rocketman123456/eyou_motor/doc/关节模组样册新20250213.pdf

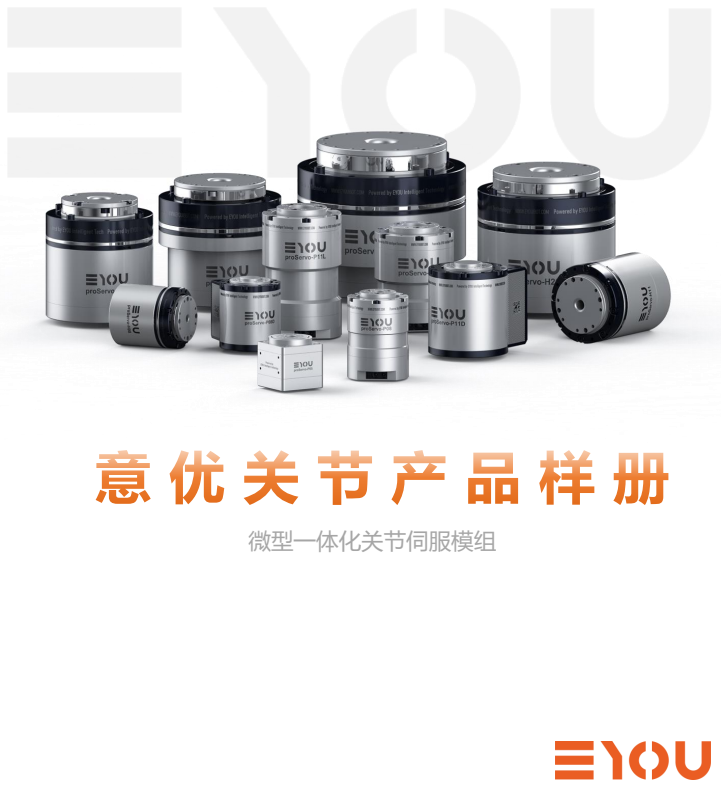
[picture p1: page 1]
意优关节产品样册; 微型一体化关节伺服模组

# 关于意优

### ABOUT EYOU

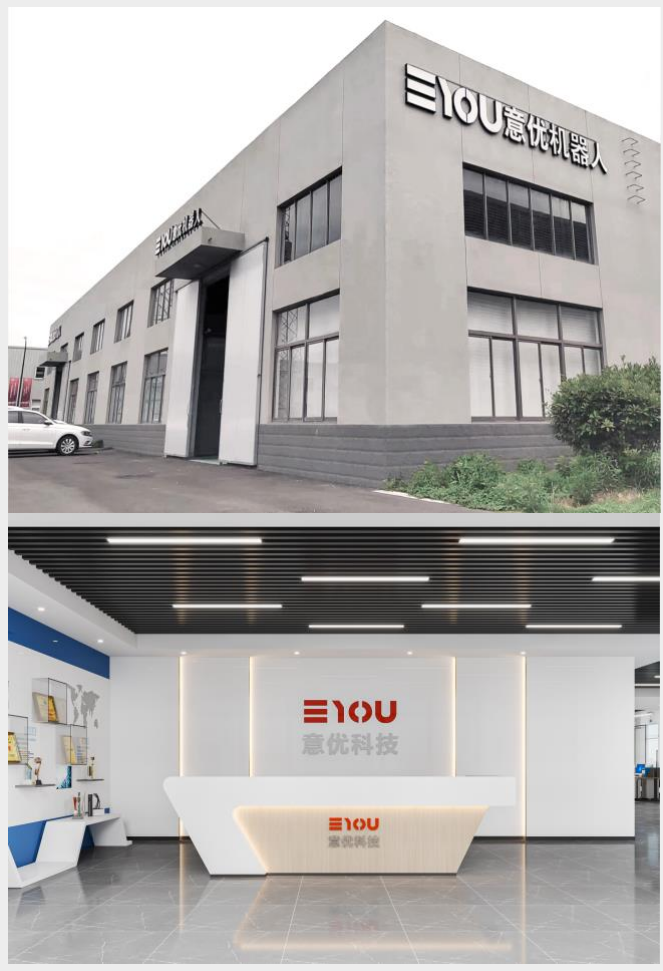
[picture p2: figure]

江苏意优机器人科技有限公司致力于人形机
器人驱动系统的研发、生产和销售，核心团队基
于20多年的机器人研发经验，突破了关节驱控的
高精度控制算法，推出的行星、谐波及推杆关节
模组，涵盖了人形机器人上肢、腰部、下肢能用
到的全身关节，是国内人形机器人核心零部件的
头部供应商。

意优伺服关节模组性能稳定，成本低，已实
现规模量产，产品不仅广泛应用于协作机械臂、
医疗器械、工业模组、智能制造等各种工业机器
人领域，在服务、教育、娱乐等各种人形机器人
应用场景也有着不可取代的地位。

公司研发和运营中心位于江苏无锡中电数字
芯谷，从事人研发人员30余人，生产场地3500平，
依托人形机器人创新链和产业链的有效赋能，意
优机器人多次签约重点重大项目，加入产业集群，
为未来产业发展注入新动力。

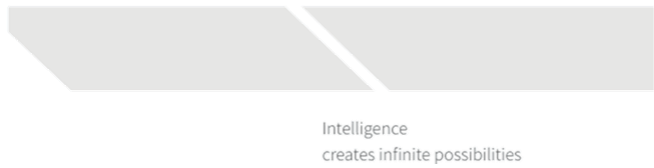
[picture p3: figure]

# 微型一体化伺服模组

### INTEGRATED SERVO MODULE

CHARACTERISTIC

### 技术特点

创新的产品设计

PROSERVO系列伺服，将减速器、电机、驱动三大部件高度集成，形成超小型一体化的伺服模组，

关节采用总线设计，中空走线，大大简化系统结构。 采用高精度双磁编设计，可选抱闸，满足

各种苛刻工况要求。

标准化生产工厂和检测设备

全硬件FPGA驱动设计，速度环、位置环、力矩环闭环速度均达到20KHZ，提供快速动态响应，

同时满足协作机械臂柔性和精度要求。 伺服算法采用ADRC技术，运行更加平稳。

全面的配套软件服务和技术支持

上位机支持LINUX、WINDOWS、树莓派；SDK支持C++\PYTHON\MATLAB\ROS;接口支持USBCAN，

提供CANOPEN主站；为客户多元需求提供专业的解决方案。

高标准配件

高精度21BIT磁环编码器、高能量密度电机、高精度减速器、磁环抱闸，均采用一线品牌合作，

并配置专门的生产厂线，从而确保产能和质量。

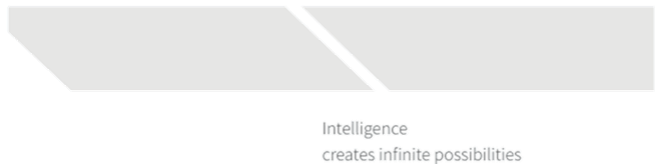
[picture p4: figure]

# 行星一体化伺服关节模组

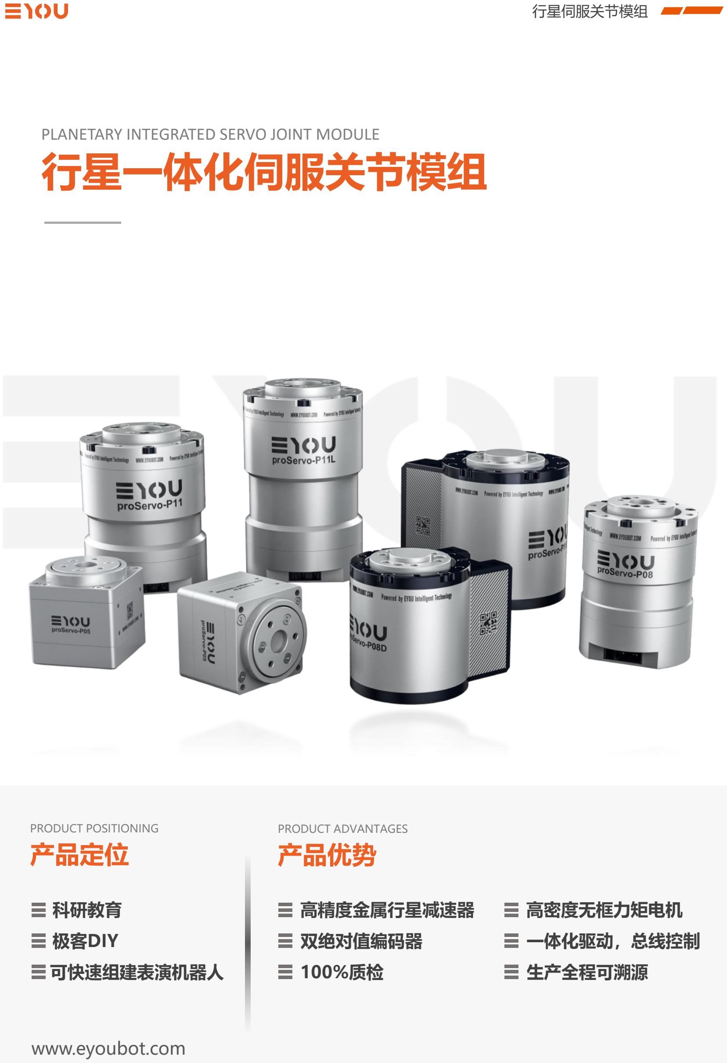
[picture p5: page 4]

PRODUCT POSITIONING

## 产品定位

科研教育
极客DIY

高精度金属行星减速器
双绝对值编码器

PRODUCT ADVANTAGES

## 产品优势

高密度无框力矩电机
一体化驱动，总线控制
可快速组建表演机器人 | 100%质检 | 生产全程可溯源

PLANETARY INTEGRATED SERVO JOINT MODULE

www.eyoubot.com

行星伺服关节模组

PRODUCT ADVANTAGES

# 产品优势

CAN2.0总线
接口频率1MHz

机械式双编码器
精度18bit*2

4点接触轴承，承
受 轴向径向负荷

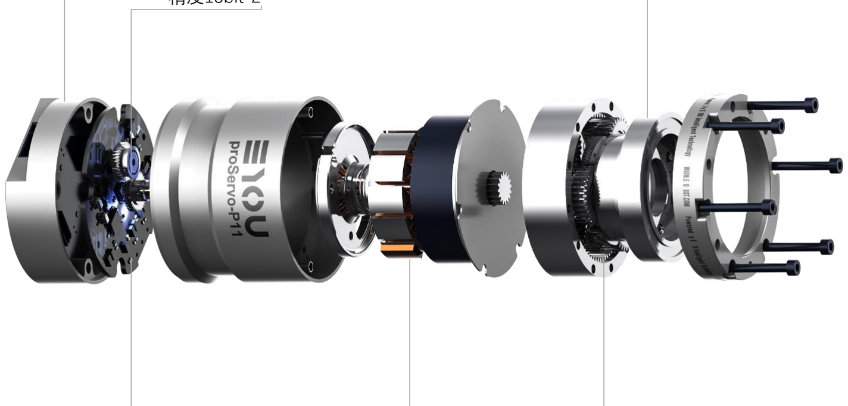
[picture p6: figure]

全硬件FOC驱动
20KHz闭环 周期

高密度无框
力矩电机

精密行星减速器，
高强度低噪音

行星伺服关节模组

www.eyoubot.com

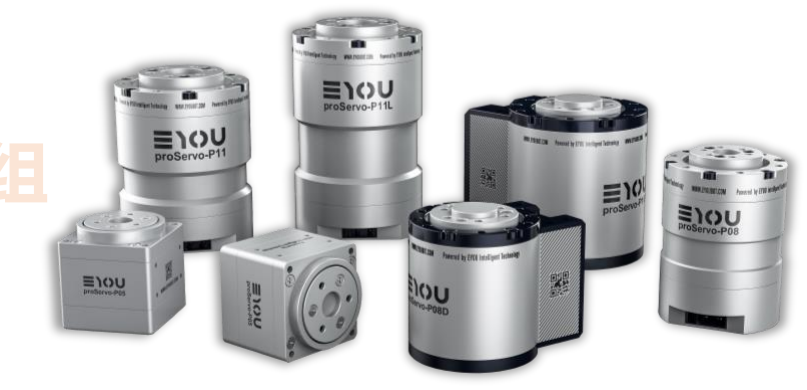
[picture p7: figure]

型号 | PP05 | PP08/PP08D | PP11/PP11D | PP11L-36
电机类型 | 无刷力矩电机
减速器类型 | 行星减速器
直径（mm） | 32 | 40 | 52 | 52
长度（mm） | 33.4 | 52/48 | 64/61 | 83
重量（g） | 82 | 190/199 | 391/436 | 517
减速比 | 6:1 | 36:1
反向背隙 （arcmin） | 12arcmin
噪音（db） | <70db
温度范围（℃） | -20~80℃
工作电压(V) | 24V
最大功率（W） | 36W
额定转速（rpm） | 50rpm
空载转速（rpm） | 200rpm | 80rpm | 80rpm | 50rpm
额定扭矩（nm） | 0.2nm | 1.0nm | 6.6nm | 12nm
峰值扭矩（nm） | 0.48nm | 2.2nm | 14nm | 16nm
转矩系数 （nm/a） | 0.2nm/a | 1.1nm/a | 2.2nm/a | 6nm
轴向承受力（N） | - | 1284 | 1605 | 1605
径向承受力（N） | - | 2520 | 3150 | 3150

# 产品参数

# 行星一体化关节模组

行星伺服关节模组

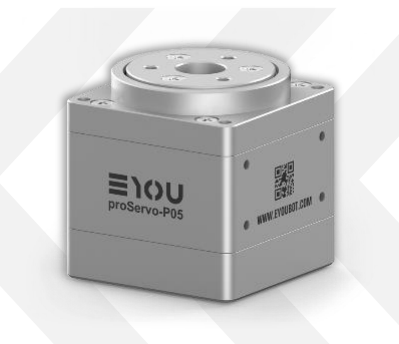
[picture p8: figure]

型号 | 速比 | 无抱闸
PP05-6 | 6 | N

无刷力矩电机

产品名称 Item Name | PP05
直径 | 32mm | 额定转速 | 50rpm
长度 | 33.4mm | 空载转速 | 200rpm
重量 | 82g | 额定扭矩 | 0.2nm
反向背隙 | 12arcmin | 峰值扭矩 | 0.48nm
噪音 | <70db | 扭矩系数 | 0.2nm/a
温度范围 | -20~80℃ | 轴向承受力 | -
工作电压 | 24V | 径向承受力 | -
额定功率 | 35w

行星伺服关节模组

### 系列名 Series Name

## proServo-planet

### 电机型号 Motor model

PP05-6

尺寸安装图 Installation Drawing

产品参数 product parameters

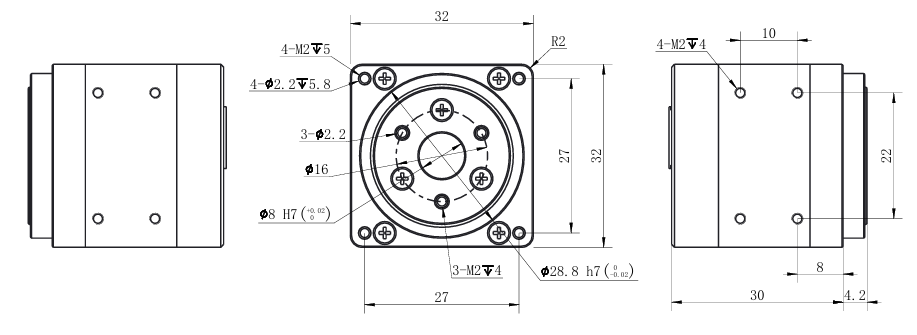
[picture p9: figure]

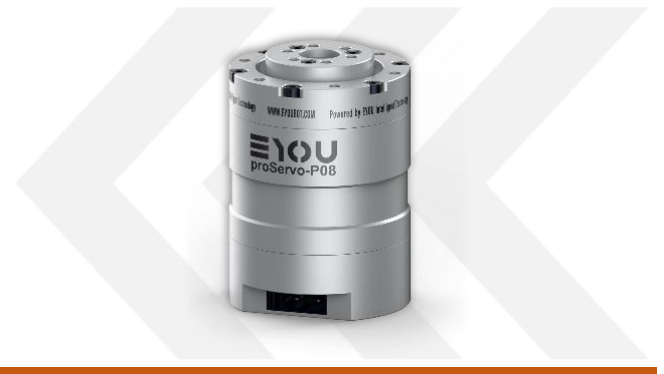
[picture p10: figure]

型号 | 速比 | 无抱闸
PP08-36 | 36 | N

无刷力矩电机

产品名称 Item Name | PP08
直径 | 40mm | 额定转速 | 50rpm
长度 | 52mm | 空载转速 | 80rpm
重量 | 190g | 额定扭矩 | 1.0nm
反向背隙 | 12arcmin | 峰值扭矩 | 2.2nm
噪音 | <70db | 扭矩系数 | 1.1nm/a
温度范围 | -20~80℃ | 轴向承受力 | 1284N
工作电压 | 24V | 径向承受力 | 2520N
额定功率 | 36w

行星伺服关节模组

### 系列名 Series Name

## proServo-planet

### 电机型号 Motor model

# PP08-36_V3

尺寸安装图 Installation Drawing

产品参数 product parameters

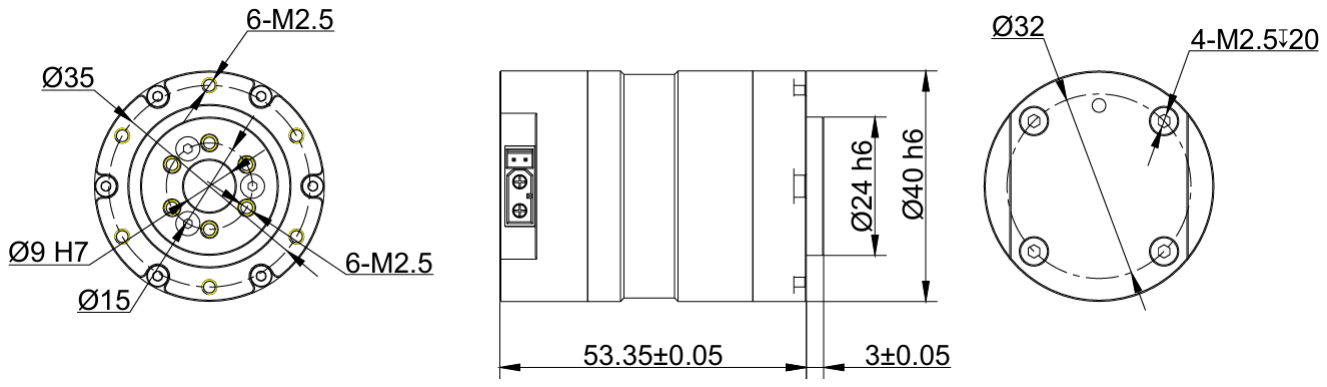
[picture p11: figure]

### 系列名 Series Name

## proServo-planet

### 电机型号 Motor model

# PP08D-36_V3

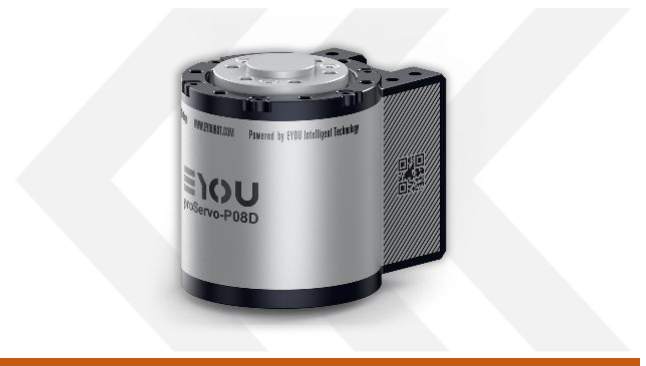
[picture p12: figure]

型号 | 速比 | 无抱闸
PP08D-36 | 36 | N

无刷力矩电机

产品名称 Item Name | PP08D
直径 | 40mm | 额定转速 | 50rpm
长度 | 48mm | 空载转速 | 80rpm
重量 | 199g | 额定扭矩 | 1.0nm
反向背隙 | 12arcmin | 峰值扭矩 | 2.2nm
噪音 | <70db | 扭矩系数 | 1.1nm/a
温度范围 | -20~80℃ | 轴向承受力 | 1284N
工作电压 | 24V | 径向承受力 | 2520N
额定功率 | 36w

行星伺服关节模组

尺寸安装图 Installation Drawing

产品参数 product parameters

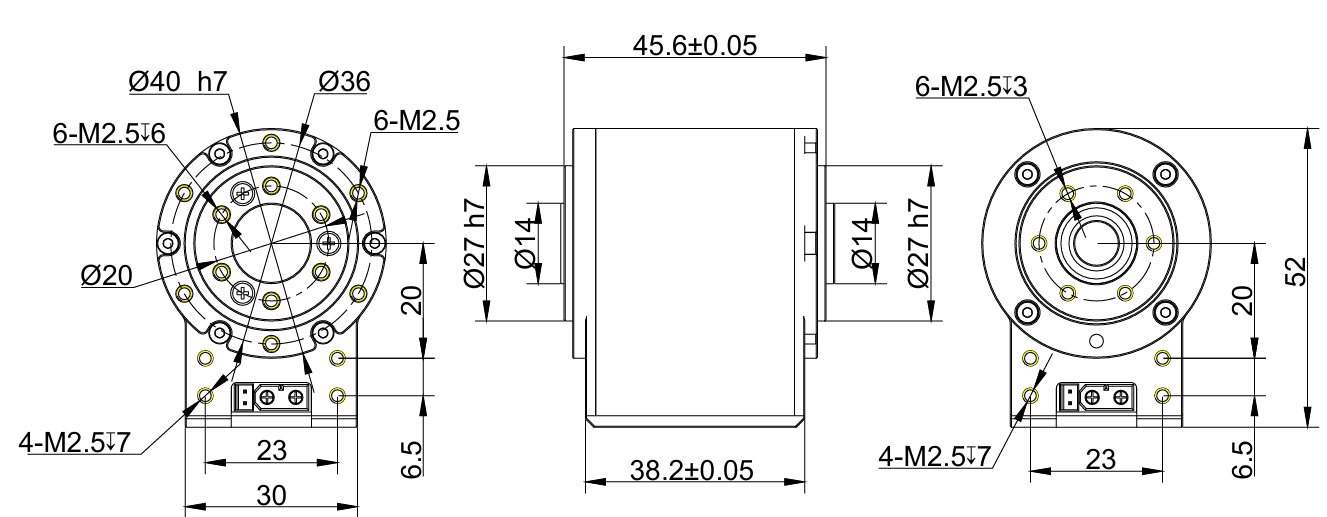
[picture p13: figure]

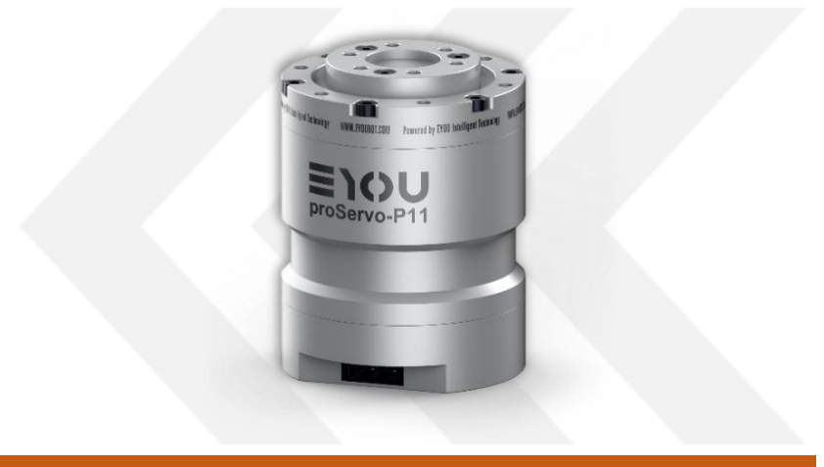
[picture p14: figure]

型号 | 速比 | 无抱闸
PP11-36 | 36 | N

无刷力矩电机

产品名称 Item Name | PP11
直径 | 52mm | 额定转速 | 50rpm
长度 | 64mm | 空载转速 | 80rpm
重量 | 391g | 额定扭矩 | 6.6nm
反向背隙 | 12arcmin | 峰值扭矩 | 14nm
噪音 | <70db | 扭矩系数 | 2.2nm/a
温度范围 | -20~80℃ | 轴向承受力 | 1605N
工作电压 | 24V | 径向承受力 | 3150N
额定功率 | 60w

### 系列名 Series Name

## proServo-planet

### 电机型号 Motor model

# PP11-36_V3

行星伺服关节模组

尺寸安装图 Installation Drawing

产品参数 product parameters

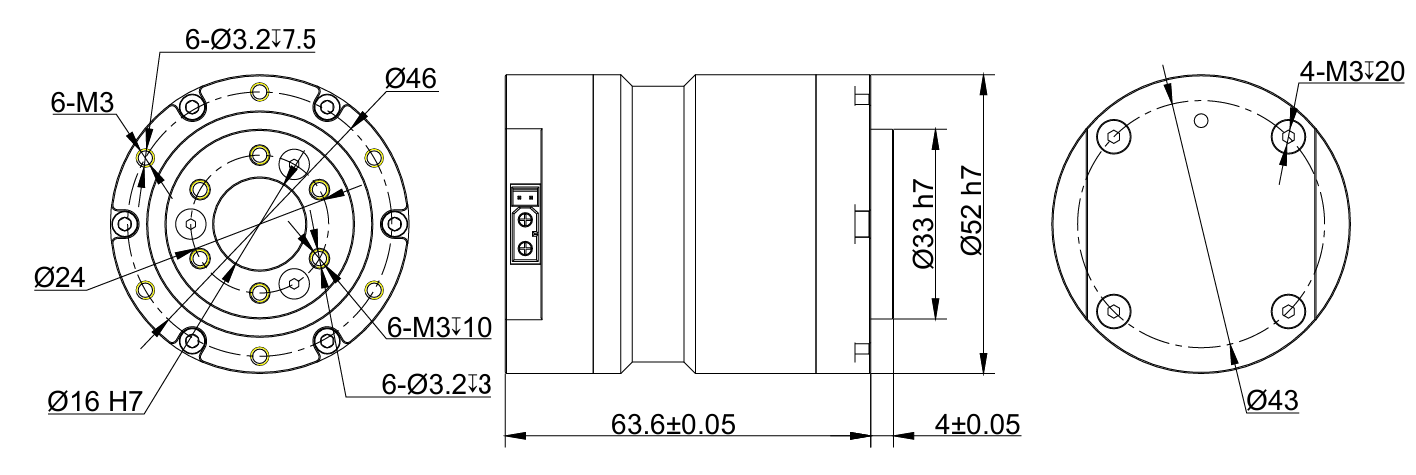
[picture p15: figure]

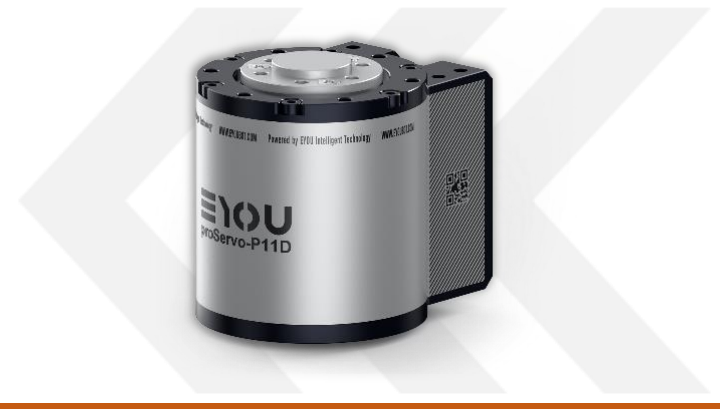
[picture p16: figure]

型号 | 速比 | 无抱闸
PP11D-36 | 36 | N

无刷力矩电机

产品名称 Item Name | PP11D
直径 | 52mm | 额定转速 | 50rpm
长度 | 61mm | 空载转速 | 80rpm
重量 | 436g | 额定扭矩 | 6.6nm
反向背隙 | 12arcmin | 峰值扭矩 | 14nm
噪音 | <70db | 扭矩系数 | 2.2nm/a
温度范围 | -20~80℃ | 轴向承受力 | 1605N
工作电压 | 24V | 径向承受力 | 3150N
额定功率 | 60w

### 系列名 Series Name

## proServo-planet

### 电机型号 Motor model

# PP11D-36_V3

行星伺服关节模组

尺寸安装图 Installation Drawing

产品参数 product parameters

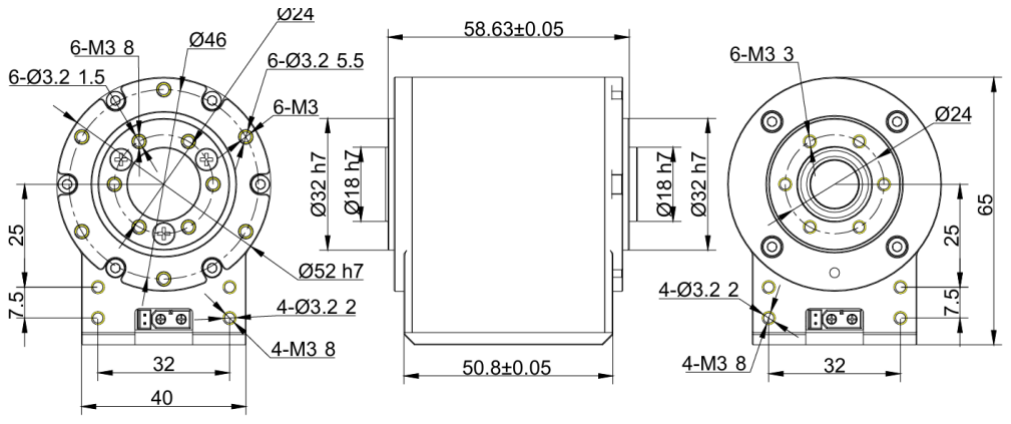
[picture p17: figure]

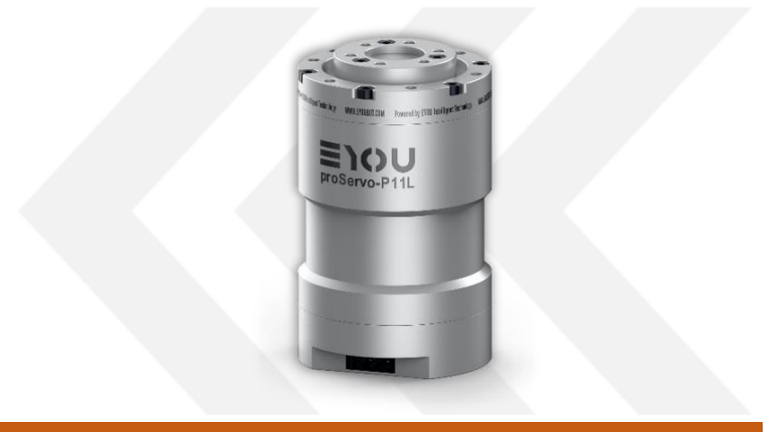
[picture p18: figure]

型号 | 速比 | 无抱闸
PP11L-36 | 36 | N

无刷力矩电机

产品名称 Item Name | PP11L
直径 | 52mm | 额定转速 | 50rpm
长度 | 82mm | 空载转速 | 50rpm
重量 | 517g | 额定扭矩 | 12nm
反向背隙 | 12arcmin | 峰值扭矩 | 18nm
噪音 | <70db | 扭矩系数 | 6nm/a
温度范围 | -20~80℃ | 轴向承受力 | 1605N
工作电压 | 24V | 径向承受力 | 3150N
额定功率 | 72w

尺寸安装图 Installation Drawing

产品参数 product parameters

### 系列名 Series Name

## proServo-planet

### 电机型号 Motor model

# PP11L-36_V3

行星伺服关节模组

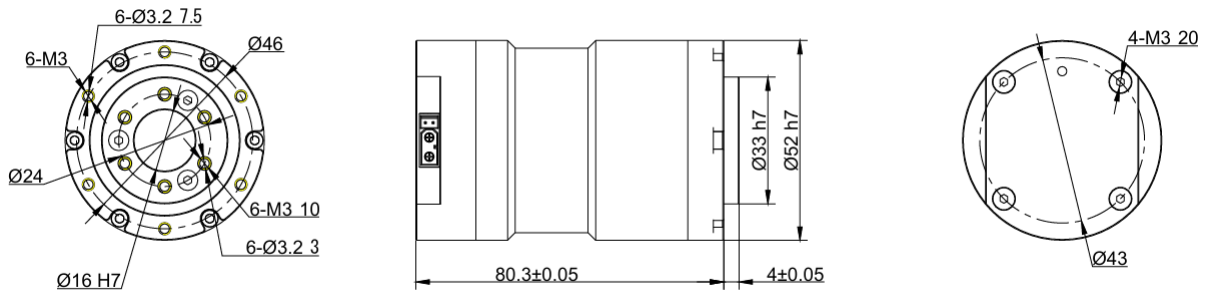
[picture p19: figure]

# 谐波一体化伺服关节模组

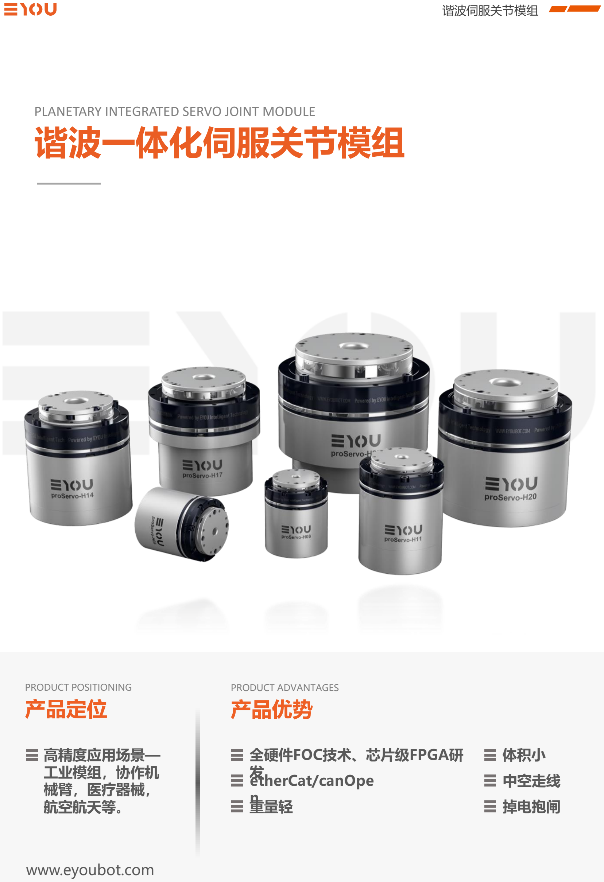
[picture p20: page 13]

PRODUCT POSITIONING

## 产品定位

高精度应用场景—
工业模组，协作机
械臂，医疗器械，
航空航天等。

全硬件FOC技术、芯片级FPGA研
发etherCat/canOpe
n

PRODUCT ADVANTAGES

## 产品优势

体积小
中空走线
重量轻 | 掉电抱闸

PLANETARY INTEGRATED SERVO JOINT MODULE

www.eyoubot.com

谐波伺服关节模组

PRODUCT ADVANTAGES

# 产品优势

谐波伺服关节模组

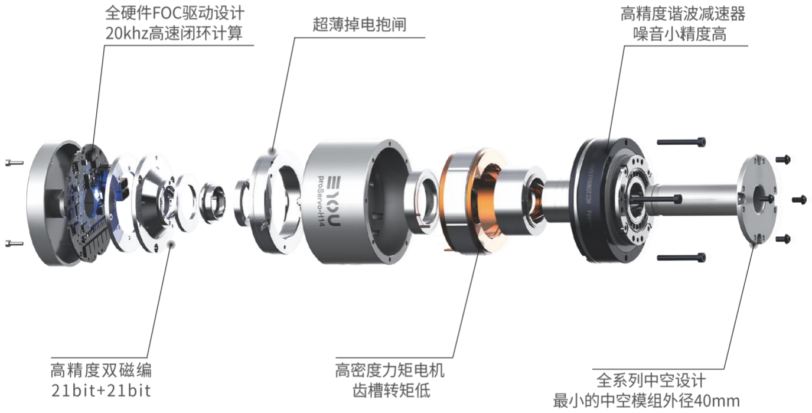
[picture p21: figure]

www.eyoubot.com

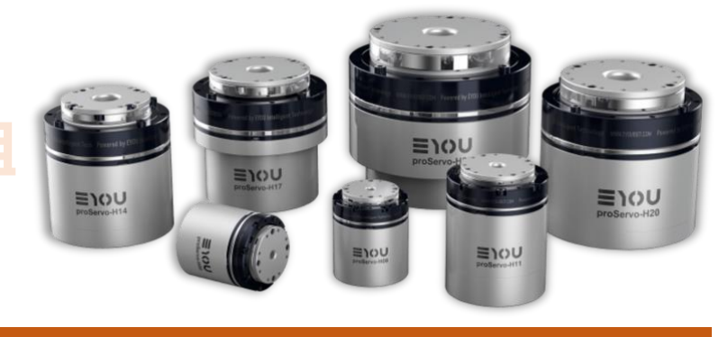
[picture p22: figure]

型号 | PH08 | PH11 | PH14 | PH17 | PH20 | PH25
电机类型 | 内转子力矩电机
减速器类 型 | 谐波减速器
直径 | 40mm | 52mm | 70mm | 80mm | 90mm | 110mm
中空内径 | 4.6mm | 6mm | 10.3mm | 10.3mm | 13mm | 13mm
重量（g） (有/无抱闸） | 185 | 495 | 434 | 1108 | 928 | 1186 | 1098 | 1808 | 1635 | 2795 | 2687
反向背隙 | 15arcsec
噪音 | <70（db）
温度范围 | -20~80℃
工作电压 | 24~36V | | | 24~48V
最大功率 | 36W | 60W | 120W | 200W | 250W | 500W
减速比 | 51 | 101 | 51 | 101 | 51 | 101 | 51 | 101 | 81 | 121 | 81 | 121
额定转速
（rpm）
60 | 30 | 60 | 30 | 60 | 30 | 60 | 30 | 30 | 18 | 30 | 20

额定扭矩
（nm)
1.0 | 1.6 | 3.5 | 6.8 | 12 | 14 | 22 | 38 | 50 | 60 | 96 | 120

峰值扭矩
（nm）
2.3 | 3.5 | 6.8 | 13.6 | 30 | 38 | 52 | 66 | 104 | 110 | 206 | 200

编码器精
度
| | | | | | 19bit

编码器形
式
| | | | | | 双编码器
电磁抱闸 | 无抱闸 | 掉电抱闸

谐波伺服关节模组

# 产品参数

# 谐波一体化关节模组

### 系列名 Series Name

## proServo-Harmonic

### 电机型号 Motor model

PH08

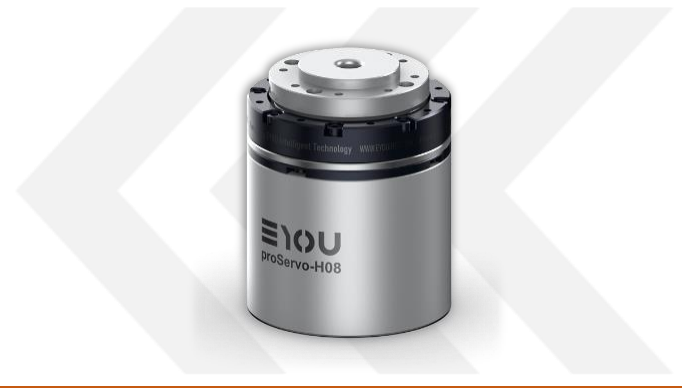
[picture p23: figure]

型号 | 速比 | 无抱闸
PH08-51 | 51 | N
PH08-101 | 101 | N

双编码器Dual Encoders

产品名称 Item Name | PH08
直径 | 40mm | 额定功率 | 36W
中空内径 | 4.4mm | 速比 | 51 | 101
重量（有/无抱闸） | 无/185g | 编码器精度 | 19bit
反向背隙 | 15arcsec | 额定转速 | 60rpm | 30rpm
噪音 | <70db | 额定扭矩 | 1.0nm | 1.6nm
温度范围 | -20~80℃ | 峰值扭矩 | 2.8nm | 3.5nm
工作电压 | 24~36V | 编码器形式 | 双磁编

谐波伺服关节模组

尺寸安装图 Installation Drawing

产品参数 product parameters

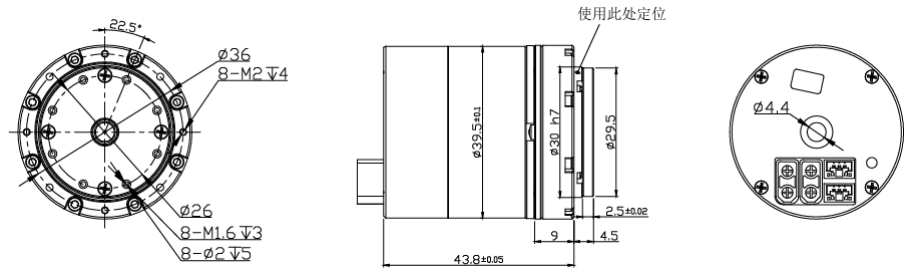
[picture p24: figure]

### 系列名 Series Name

## proServo-Harmonic

### 电机型号 Motor model

PH11

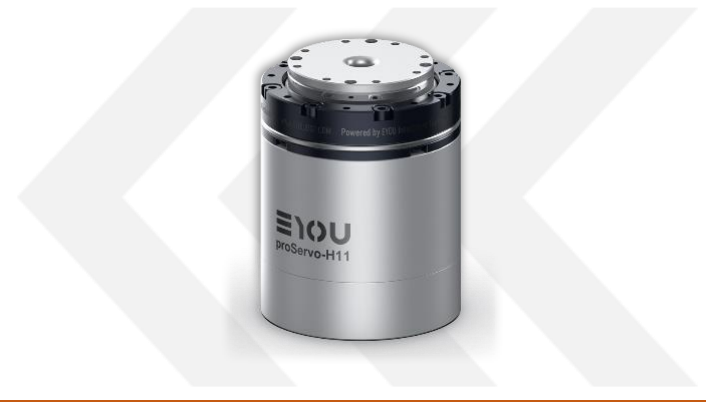
[picture p25: figure]

型号 | 速比 | 抱闸/无抱闸
PH11-51 | 51 | B/N
PH11-101 | 101 | B/N

双编码器Dual Encoders

产品名称 Item Name | PH11
直径 | 52mm | 额定功率 | 60w
中空内径 | 6mm | 速比 | 51 | 101
重量（有/无抱闸） | 495g/434g | 编码器精度 | 19bit
反向背隙 | 15arcsec | 额定转速 | 60rpm | 30rpm
噪音 | <70db | 额定扭矩 | 3.5nm | 6.8nm
温度范围 | -20~80℃ | 峰值扭矩 | 6.8nm | 13.6nm
工作电压 | 24~36V | 编码器形式 | 双磁编

尺寸安装图 Installation Drawing

产品参数 product parameters

谐波伺服关节模组

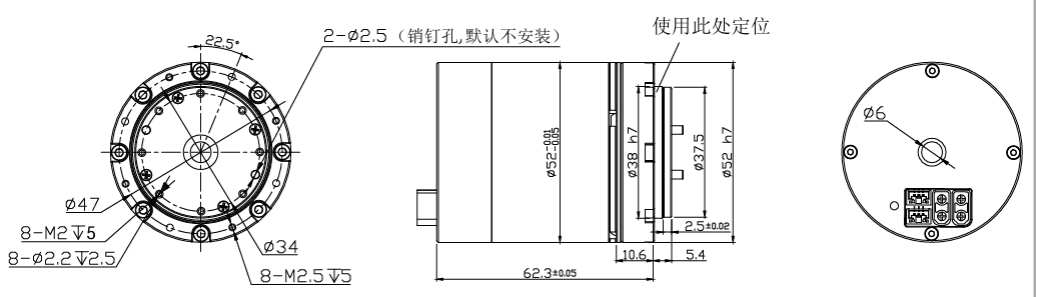
[picture p26: figure]

### 系列名 Series Name

## proServo-Harmonic

### 电机型号 Motor model

PH14

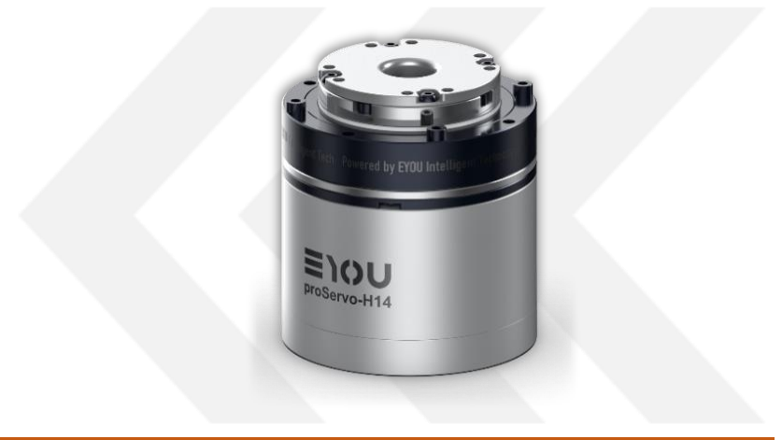
[picture p27: figure]

型号 | 速比 | 抱闸/无抱闸
PH14-51 | 51 | B/N
PH14-101 | 101 | B/N

双编码器Dual Encoders

产品名称 Item Name | PH14
直径 | 70mm | 额定功率 | 120w
中空内径 | 10.8mm | 速比 | 51 | 101
重量（有/无抱闸） | 1108g/928g | 编码器精度 | 19bit
反向背隙 | 15arcsec | 额定转速 | 60rpm | 30rpm
噪音 | <70db | 额定扭矩 | 12nm | 14nm
温度范围 | -20~80℃ | 峰值扭矩 | 30nm | 38nm
工作电压 | 24~48V | 编码器形式 | 双磁编

谐波伺服关节模组

尺寸安装图 Installation Drawing

产品参数 product parameters

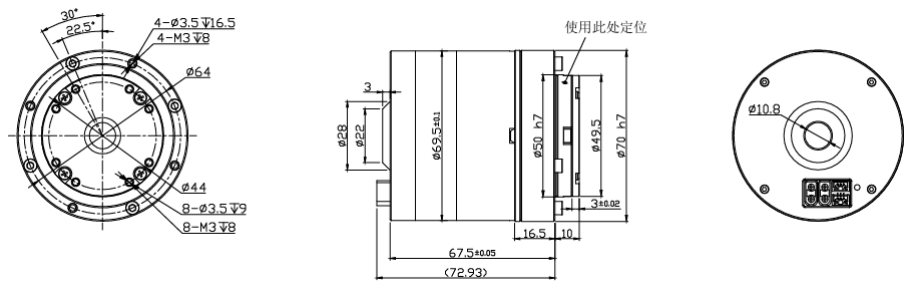
[picture p28: figure]

### 系列名 Series Name

## proServo-Harmonic

### 电机型号 Motor model

PH17

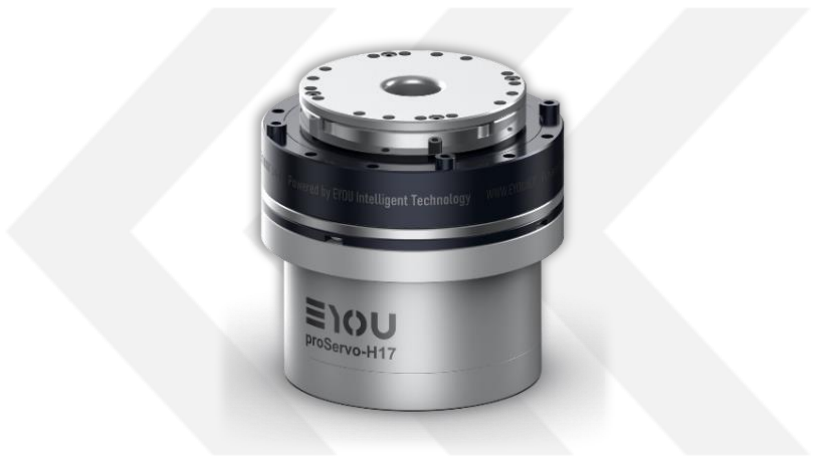
[picture p29: figure]

型号 | 速比 | 抱闸/无抱闸
PH17-51 | 51 | B/N
PH17-101 | 101 | B/N

双编码器Dual Encoders

产品名称 Item Name | PH17
直径 | 80mm | 额定功率 | 200w
中空内径 | 10.8mm | 速比 | 51 | 101
重量（有/无抱闸） | 1186g/1098g | 编码器精度 | 19bit
反向背隙 | 15arcsec | 额定转速 | 60rpm | 30rpm
噪音 | <70db | 额定扭矩 | 22nm | 38nm
温度范围 | -20~80℃ | 峰值扭矩 | 52nm | 66nm
工作电压 | 24~48V | 编码器形式 | 双磁编

谐波伺服关节模组

尺寸安装图 Installation Drawing

产品参数 product parameters

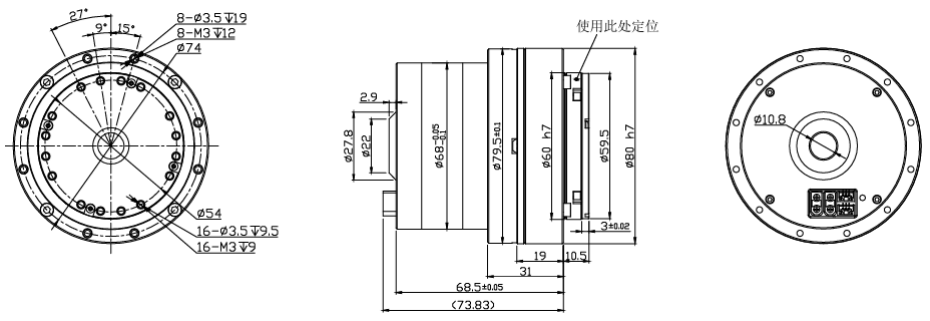
[picture p30: figure]

### 系列名 Series Name

## proServo-Harmonic

### 电机型号 Motor model

PH20

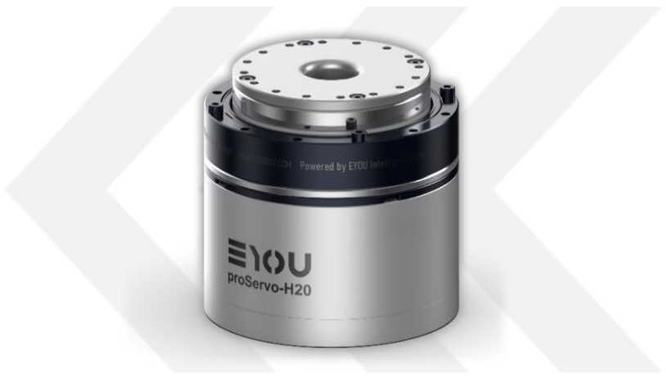
[picture p31: figure]

型号 | 速比 | 抱闸/无抱闸
PH20-81 | 81 | B/N
PH20-121 | 121 | B/N

双编码器Dual Encoders

产品名称 Item Name | PH20
直径 | 90mm | 稳定功率 | 250W
中空内径 | 13mm | 速比 | 81 | 121
重量（有/无抱闸） | 1808g/1635g | 编码器精度 | 19bit
反向背隙 | 15arcsec | 额定转速 | 30rpm | 18rpm
噪音 | <70db | 额定扭矩 | 50nm | 60nm
温度范围 | -20~80℃ | 峰值扭矩 | 104nm | 110nm
工作电压 | 24~48V | 编码器形式 | 双磁编

谐波伺服关节模组

尺寸安装图 Installation Drawing

产品参数 product parameters

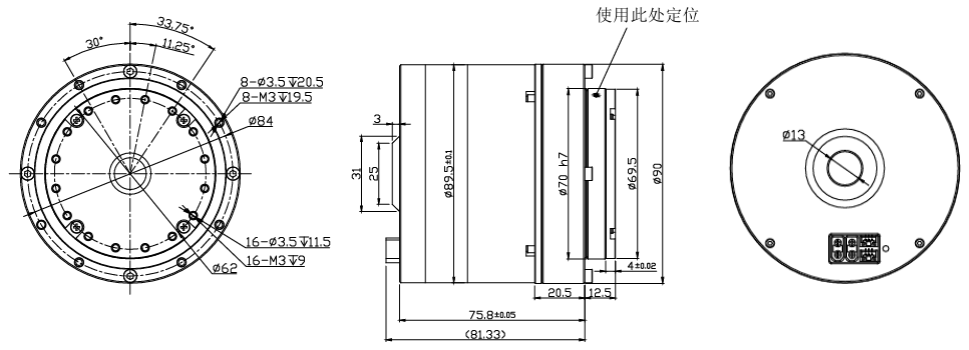
[picture p32: figure]

### 系列名 Series Name

## proServo-Harmonic

### 电机型号 Motor model

PH25

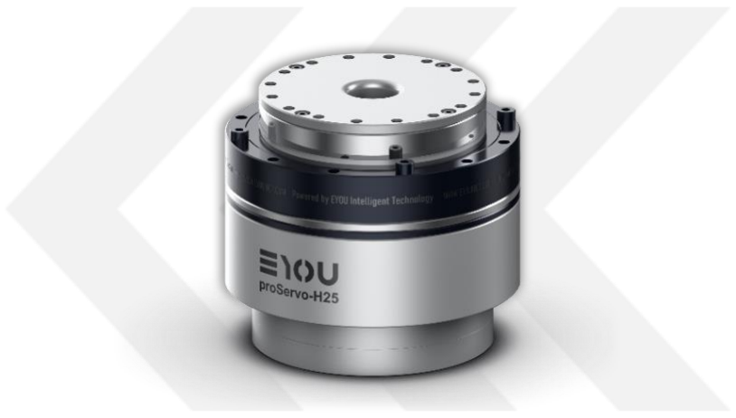
[picture p33: figure]

型号 | 速比 | 抱闸/无抱闸
PH25-81 | 81 | B/N
PH25-121 | 121 | B/N

双编码器Dual Encoders

产品名称 Item Name | PH25
直径 | 110mm | 额定功率 | 500w
中空内径 | 13mm | 速比 | 81 | 121
重量（有/无抱闸） | 2795g/2687g | 编码器精度 | 19bit
反向背隙 | 15arcsec | 额定转速 | 38rpm | 25rpm
噪音 | <70db | 额定扭矩 | 96nm | 120nm
温度范围 | -20~80℃ | 峰值扭矩 | 206nm | 200nm
工作电压 | 24~48V | 编码器形式 | 双磁编

谐波伺服关节模组

尺寸安装图 Installation Drawing

产品参数 product parameters

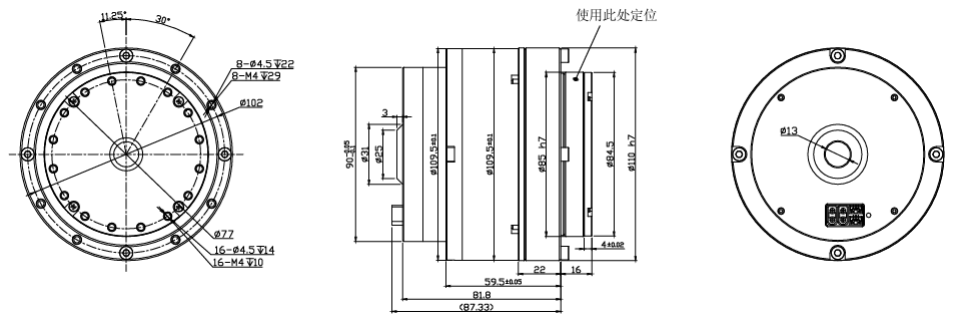
[picture p34: figure]

# 软件和支持

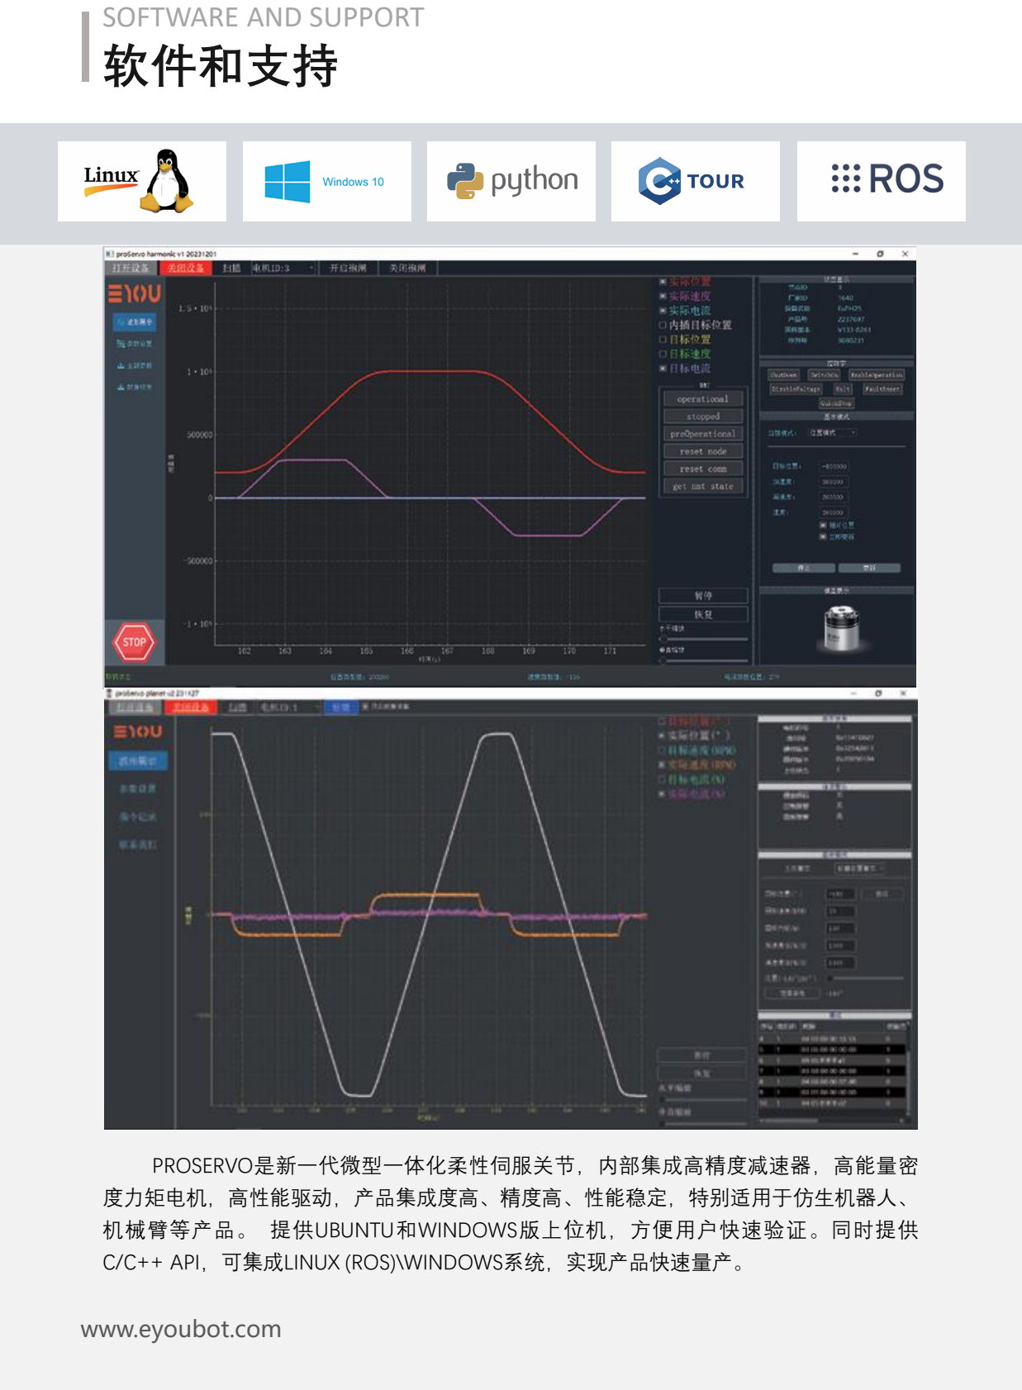
[picture p35: page 22]

### SOFTWARE AND SUPPORT

PROSERVO是新一代微型一体化柔性伺服关节，内部集成高精度减速器，高能量密 度力矩电机，高性能驱动，产品集成度高、精度高、性能稳定，特别适用于仿生机器人、 机械臂等产品。 提供UBUNTU和WINDOWS版上位机，方便用户快速验证。同时提供 C/C++ API，可集成LINUX (ROS)\WINDOWS系统，实现产品快速量产。

www.eyoubot.com

# 意 优 工 厂

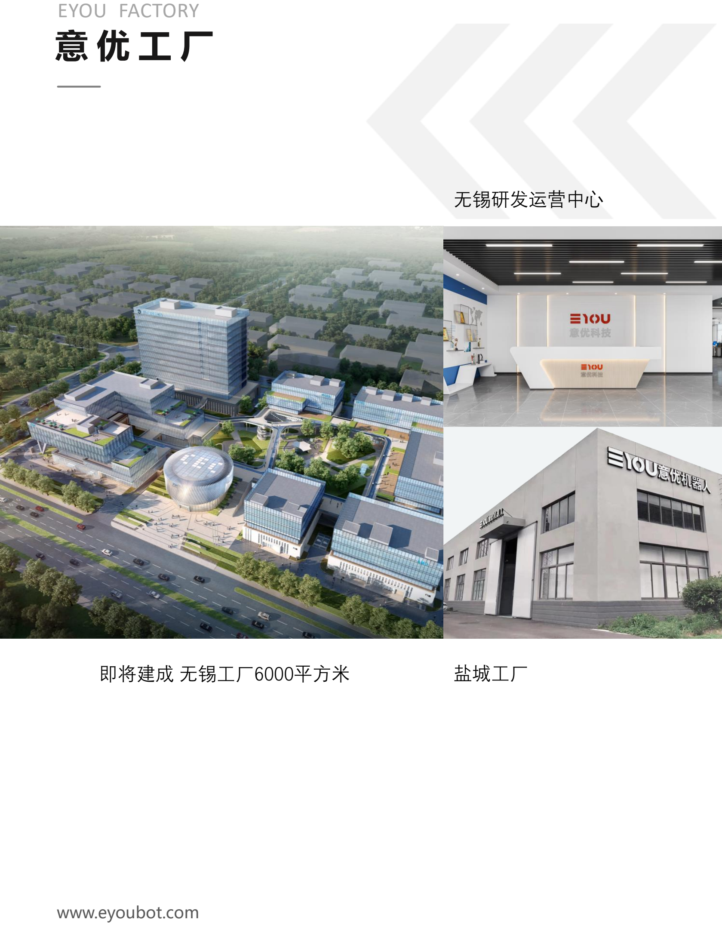
[picture p36: page 23]

即将建成 无锡工厂6000平方米 | 盐城工厂

无锡研发运营中心

### EYOU FACTORY

www.eyoubot.com

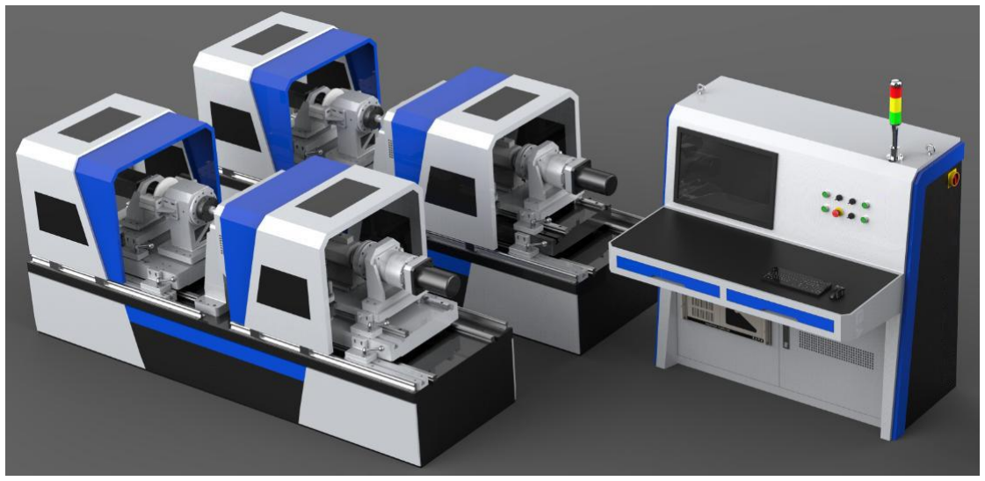
[picture p37: figure]

### 设备用途

——

高精度减速器作为高精密运动设备核心传动部件，广泛应用于自动化设备;测试台可

测试评估减速器转矩-转速、启动扭矩、反向启动扭矩、启停扭矩、空载运行扭矩、传

动效率、传动误差、扭转刚度、空程、滞回曲线、回差、温升、超载试验和耐久试验。

### JOINT DETECTION EQUIPMENT

# 关节检测设备

www.eyoubot.com

### JOINT DETECTION ITEMS

# 关节检测项

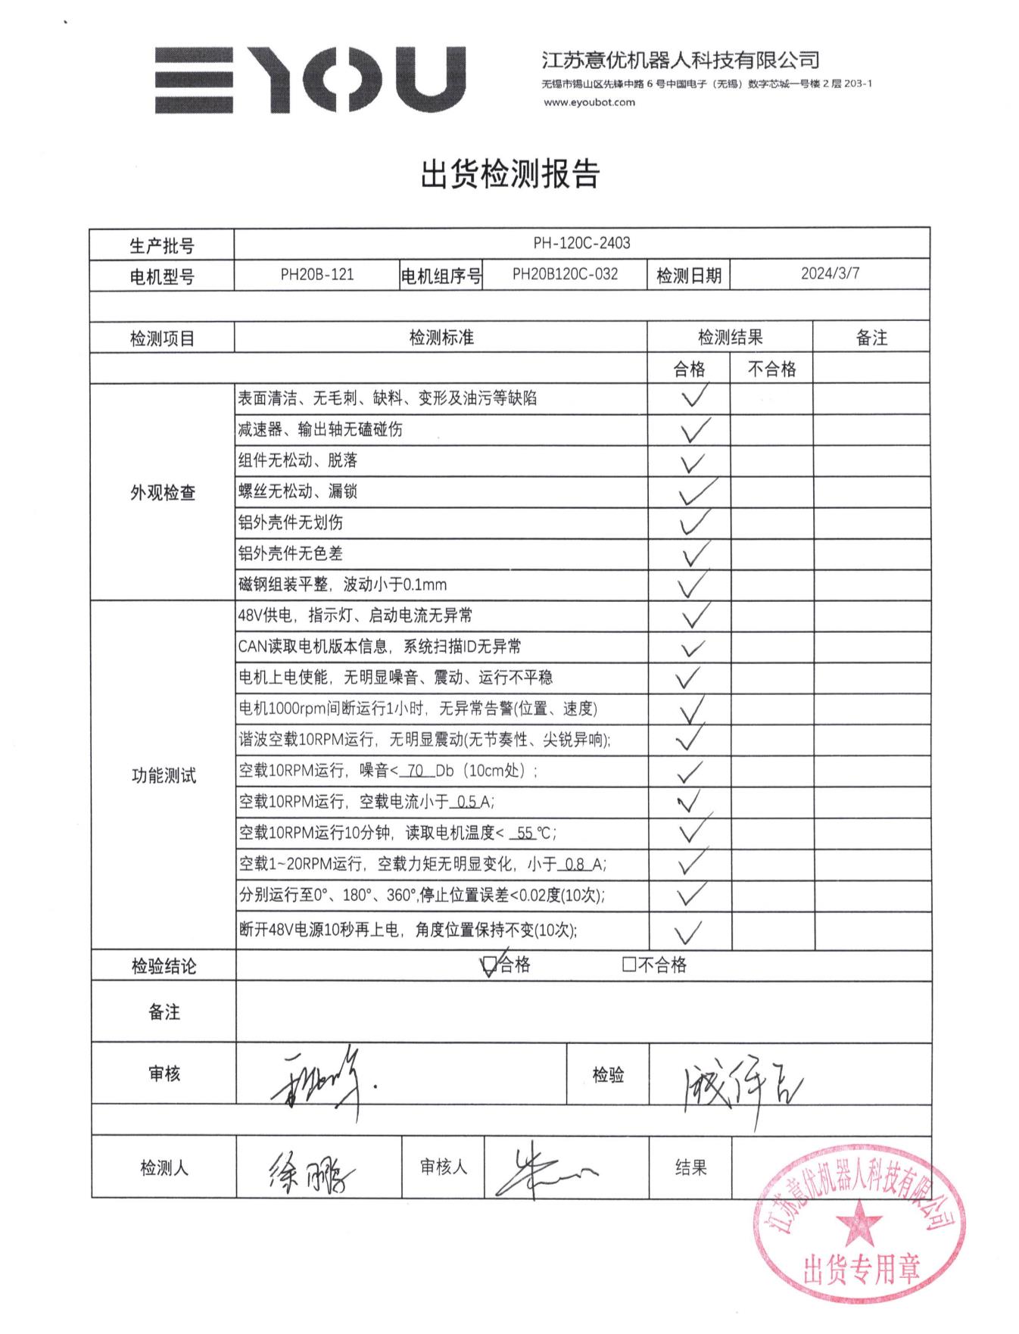
[picture p38: page 25]

www.eyoubot.com

### COLLABOPTIVE ROBOTIC ARM

# 合作平台及机构

伺服关节模组

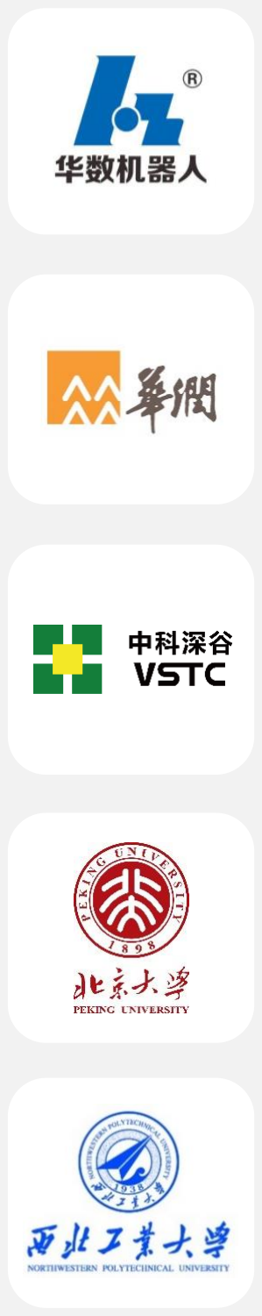
[picture p39: figure]
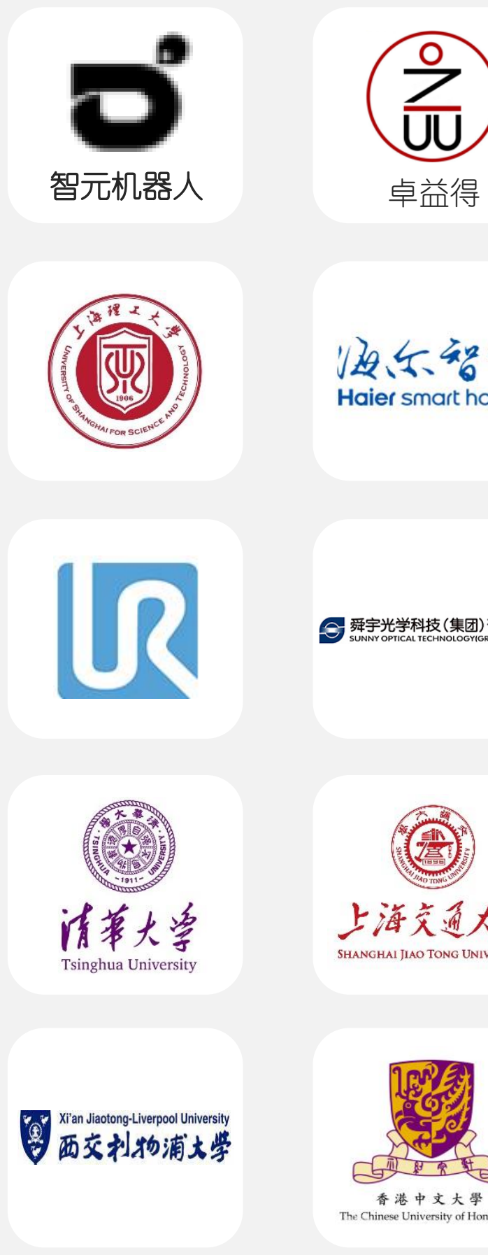
[picture p40: figure]
智元机器人; 卓益得
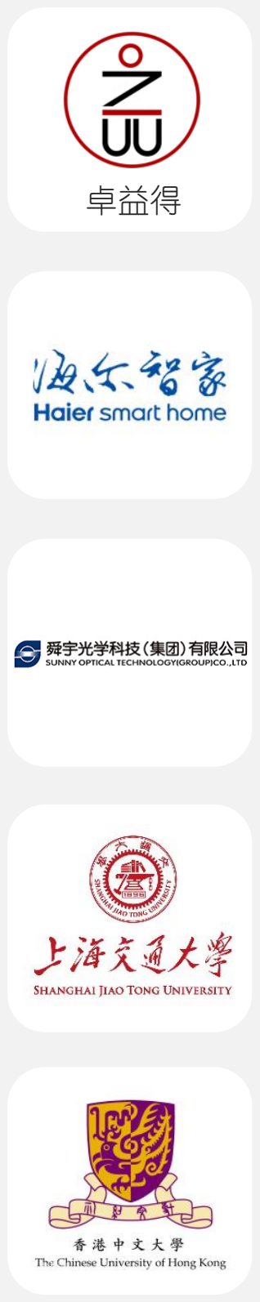
[picture p41: figure]
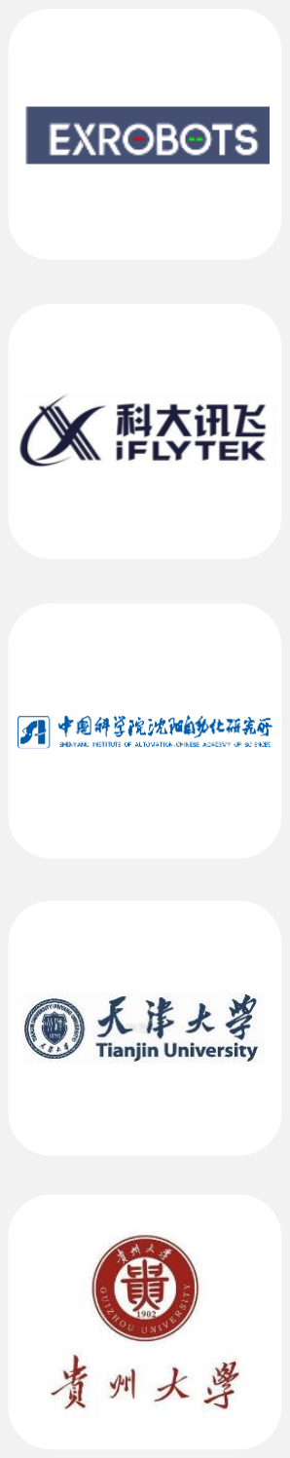
[picture p42: figure]
