rocketman123456/eyou_motor/model/谐波关节模型图2.0-241224/PH08-2.0.stp

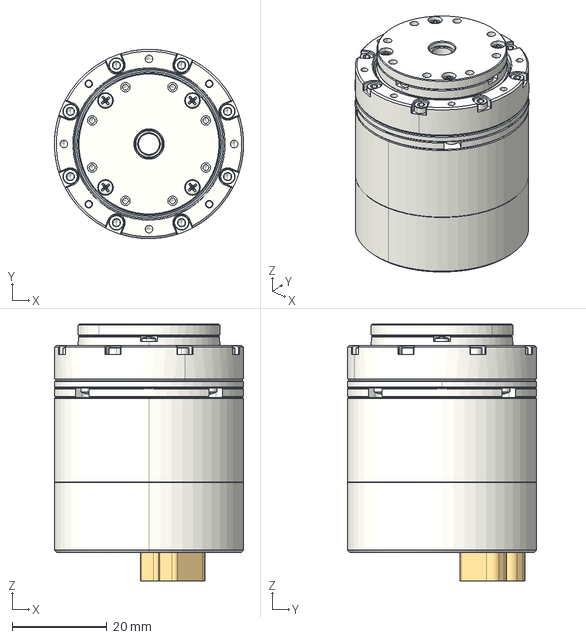
[picture p58: CAD file, 2025-03-02]
model/谐波关节模型图2.0-241224/PH08-2.0.stp
40.0 x 40.0 x 54.3 mm
PH08_01A1_18_1_1_1_1
PH08_03A1_15_1_1_1_1
