rocketman123456/eyou_motor/(list of files, cad)

Other CAD files:
model/谐波关节模型图2.1-241224/PH08-2.1.stp
model/谐波关节模型图2.1-241224/PH11-2.1.stp
