rocketman123456/eyou_motor/doc/意优CanOpen快速调试手册V2.0.pdf

# 意优 CanOpen 快速调试手册 V2.0

目录

## 1，EYouCanOpenTool 调试使用

EYouCanOpenTool 是我司开发配套 CanOpen 接口电机调试的专用上位机，windows 系 统专用，安装后打开界面如下，大致分为 12 功能区域。

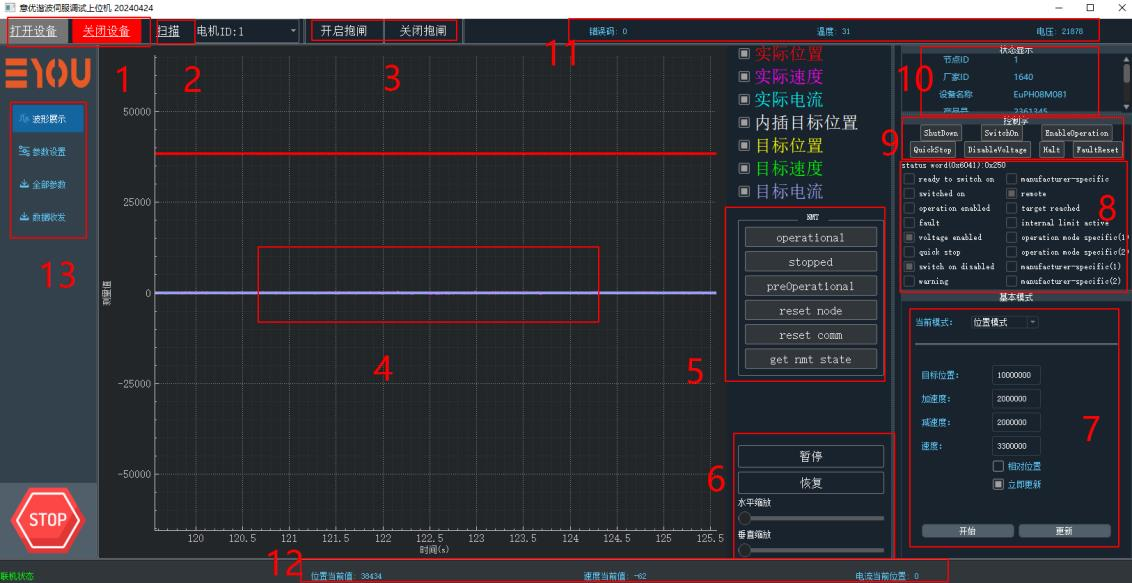
[picture p60: figure]

功能区 1：打开设备即打开 usbcan 设备，选择对应的 usbcan 设备和波特率，如果打开失败 检查类型选择、usbcan 是否插入、usbcan 驱动是否安装（canable 不需要安装驱动）、usbcan 是否被其他软件占用。关闭设备即关闭当前软件对 usbcan 的占用。
功能区 2：扫描 usbcan 总线上 canopen 电机，可能会扫描出多个 id 的电机，请选择对应的 电机进行操作。电机断电或重新插入请重新扫描。
功能区 3：抱闸单独控制，只对有抱闸电机有效。常规控制不需要单独控制抱闸，运行中关 闭抱闸（关闭抱闸励磁供电，抱闸抱死）会引起电机和抱闸摩擦。
功能区 4：波形显示，可以根据右上角勾选框选择不同的数据波形，也可以通过在此区域缩 放、拖动鼠标调整波形显示。
功能区 5：CanOpen 协议 NMT 指令区，此处可以不用过多关心，EYouCanOpenTool 中的相 关电机控制指令已自动加入 NMT 的操作。
功能区 6：波形暂停、恢复、缩放按钮。
功能区 7：运动控制区域，可以选择不同的模式，输入对应的参数进行电机控制。位置单位： pulse,速度单位 pulse/s,加减速单位：pulser/(s*s).电机一圈脉冲分辨率默认=65536*减速比。 额定电压下，最大速度=3276800（对应原始电机 3000rpm）。
功能区 8：电机实时状态字显示。
功能区 9：CanOpen 控制字快捷按钮。
功能区 10：电机产品信息区域。
功能区 11：温度、错误码、电压显示区域。
功能区 12：位置、温度、速度文字显示。

## 1.1 电机参数

## 1.1.1 输出轴分辨率

Canopen 协议电机输出轴一圈脉冲分辨率可以读取字典 6091-02 获取，如下图：

5308416 即为此电机输出轴转动一圈脉冲数（默认是 65536*减速比，即减速前原始电机按 照 16bit 输出，所以减速后一圈=65536*减速比）。截图中两个字典为电子齿轮比的分子和分 母，可以修改 6091-02 更改输出轴一圈分辨率。

## 1.1.2 输出角度范围

双磁编单圈绝对值机型，开机后输出角度为正负 180 度范围，如 81 减速比电机，开机上电 后，角度会在-2654208 至+2654208 之内。

## 1.1.3 参数单位

位置：脉冲或用户脉冲单位，如 81 减速比默认一圈 360 度对应 5308416 个脉冲。 速度：脉冲/秒，int32 类型，有正负，如 1000000，代表按照 1 秒钟增加 1000000 脉冲单位 的速度逆时针旋转。如-1000000(0Xfff0bdc0),代表按照 1 秒钟减少 1000000 脉冲单位的速度 顺时针转动。原始电机 3000rpm 速度=50rps=50*65536=3276800 脉冲/秒，我司原始电机 统一按照 16bit(65536)分辨率输出。
加速度/减速度:脉冲/（秒*秒），uint32 类型，只有正数。如 1000000 代表加速能力为 1 秒钟 可增加速度 1000000 脉冲/秒。加减速速度最大值 1E8,即 100000000 脉冲/(秒*秒)。 电流单位：千分比， 1000 对应额定扭矩(固件版本 V138 之前版本,500 对应额定扭矩)。

## 1.2 打开设备

EYouCanOpenTool 上位机目前适配 canable 和创芯的 USBCAN，canable 免驱动。将 USBCAN 的 USB 端连接至电脑，CAN1 口连接至电机端并打开一组 120R 终端电阻，并确保电源供电 正常（PH08/PH11 为 24V 供电）接线图如下：

正确连线后，点击“打开设备“按钮，默认选择电机对应波特率（电机出厂默认 1000K），如下：

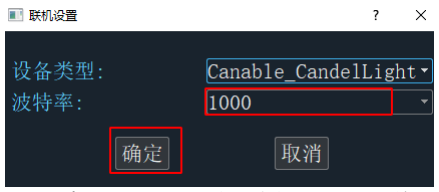
[picture p61: figure]

如果打开设备不成功，请检查 USBCAN 的驱动安装、硬件连接。正常打开后，软件会

设置电机相关的 PDO 并读取电机的全部字典数据。当多个电机连接时，点击“扫描”按钮刷 新电机 ID，并选择要操作的电机。

## 1.3 操作电机

电机正常连接后，在电机操作区域可以实现对电机的各种控制，如轨迹位置模式：

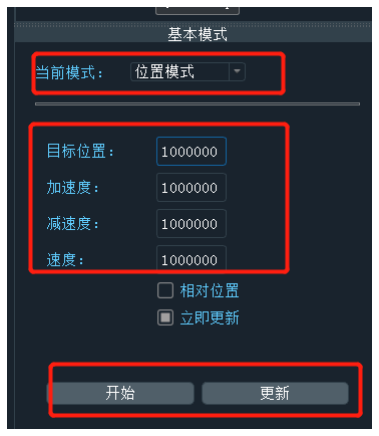
[picture p62: figure]

电机默认出厂设置的一圈 65536*减速比个脉冲（或读取 6091-02 字典查看），比如设 置加减速度、速度设置成 1000000，目标位置为 1000000，电机会运行至绝对位置 1000000 处，如果勾选相对位置，电机会在当前位置基础上加上目标位置大小的增量。其 他模式类似，可对比测试。

## 1.4 参数查看和修改

将上位机界面切换至”参数设置“,可以对电机参数进行读写、保存。首先点击[刷新控制器参 数]按钮，读取电机当前的数据。根据实际需要在修改值对应的编辑款输入修改值，然后点 击[写入电机]按钮，如果修改值需要断电保存，需要点击[保存至控制器]按钮。

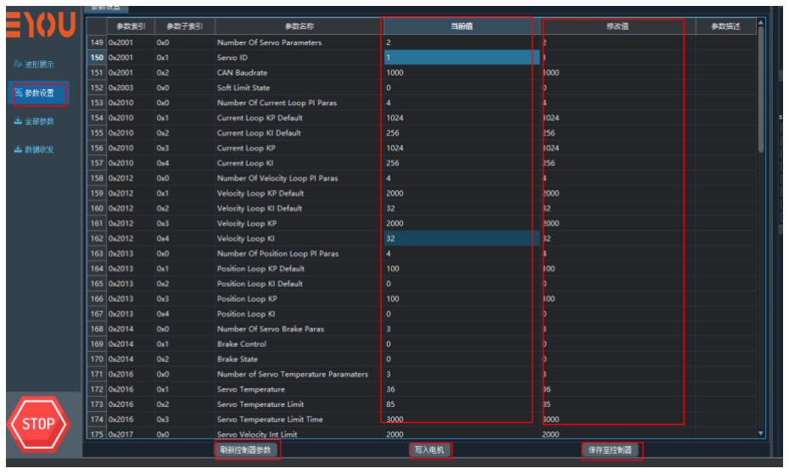
[picture p63: figure]

## 1.4.1 修改 id

参数设置界面下，修改 0x2001:01 后，断电重启生效，如下：

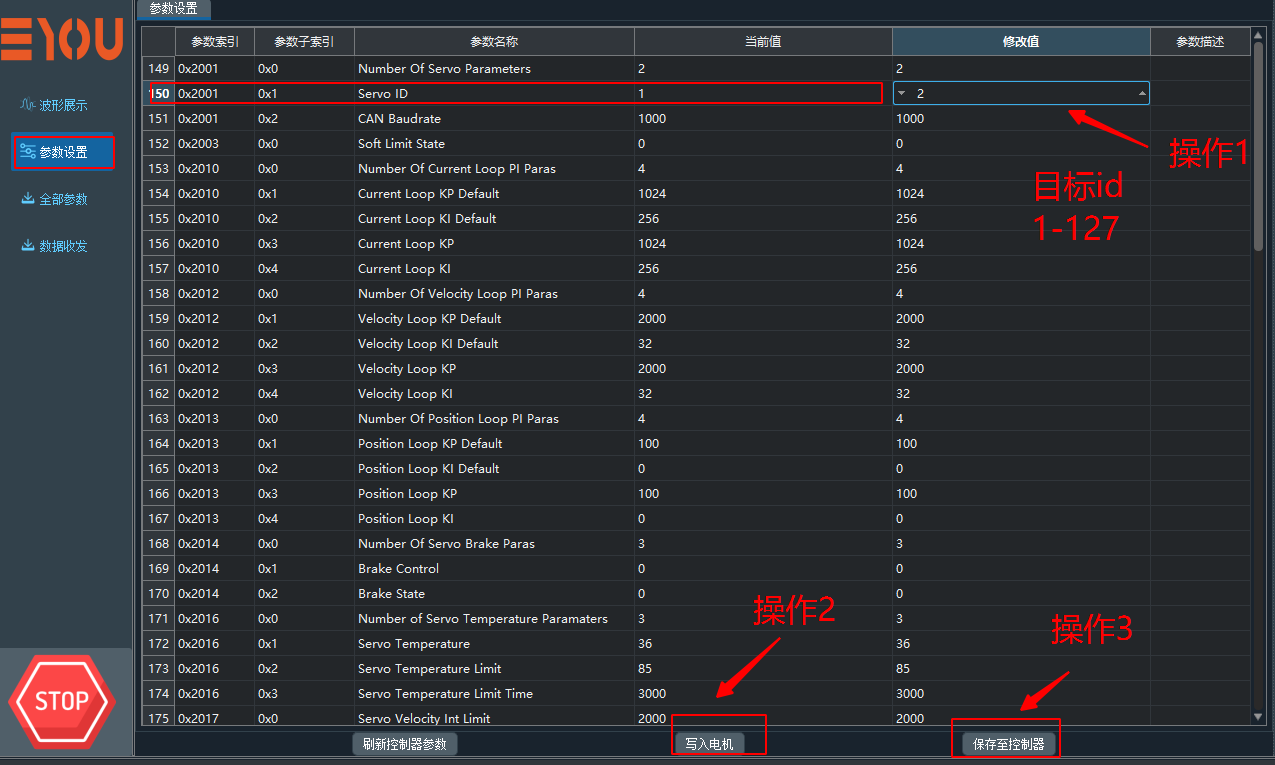
[picture p64: figure]

如果没法使用 EYouCanopenTool，也可以用下面的指令方式修改，如当前 id=1，修改 id=2， 如下：
方向 | Canid | Can 数据 | 说明
发送 | 601 | 2F 01 20 01 02 00 00 00 | 字典 2001:01 写入 02 表示设置 id=2
返回 | 581 | 60 01 20 01 00 00 00 00
发送 | 601 | 23 10 10 01 73 61 76 65 | 字典 1010:01 写入 0x65766173 保存指令
返回 | 581 | 60 10 10 01 00 00 00 00
以上指令发过后，断电重启新 id 生效。

## 1.4.2 修改波特率

参数设置界面下，修改 0x2001:02 后，断电重启生效，如下：

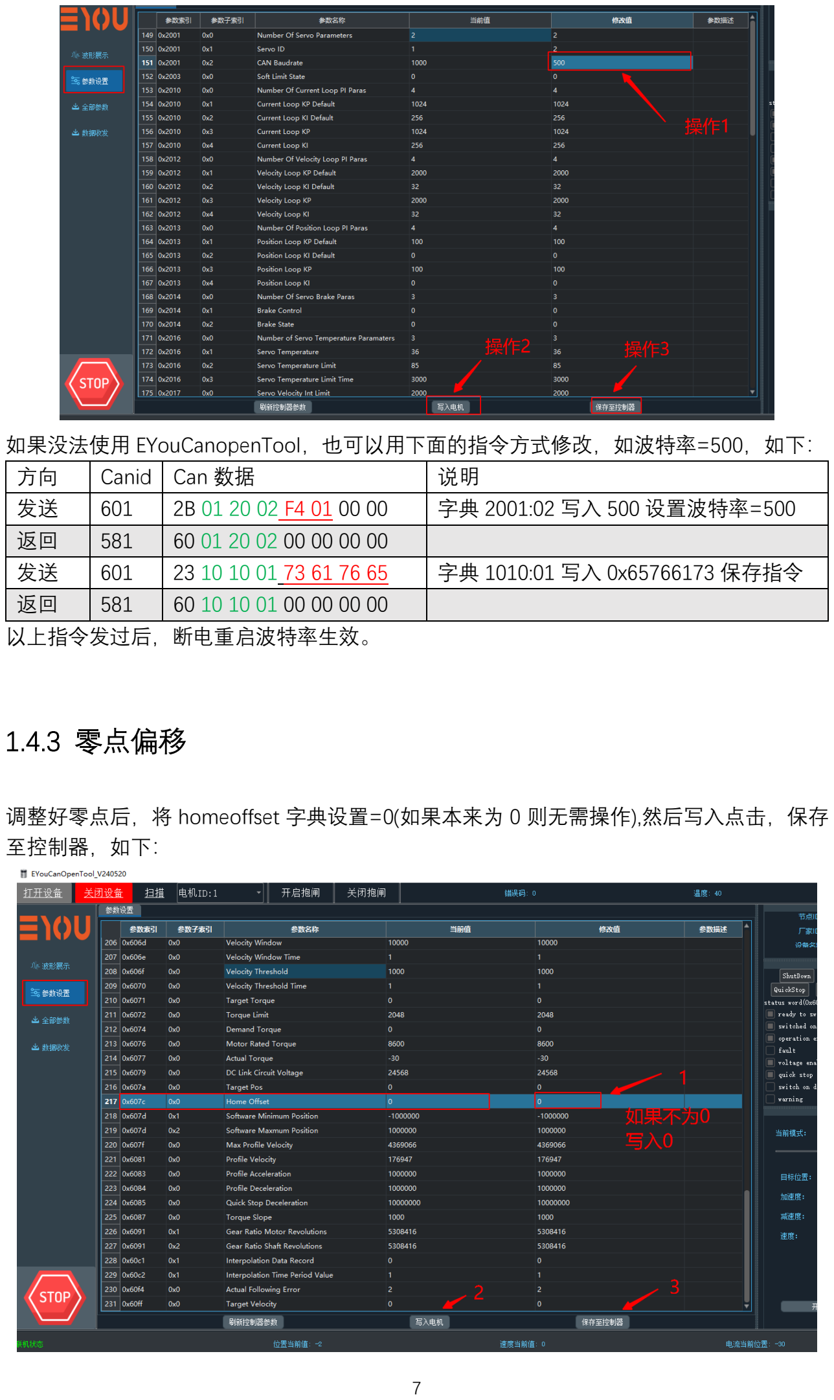
[picture p65: page 7]

如果没法使用 EYouCanopenTool，也可以用下面的指令方式修改，如波特率=500，如下：
方向 | Canid | Can 数据 | 说明
发送 | 601 | 2B 01 20 02 F4 01 00 00 | 字典 2001:02 写入 500 设置波特率=500
返回 | 581 | 60 01 20 02 00 00 00 00
发送 | 601 | 23 10 10 01 73 61 76 65 | 字典 1010:01 写入 0x65766173 保存指令
返回 | 581 | 60 10 10 01 00 00 00 00
以上指令发过后，断电重启波特率生效。

## 1.4.3 零点偏移

调整好零点后，将 homeoffset 字典设置=0(如果本来为 0 则无需操作),然后写入点击，保存 至控制器，如下：

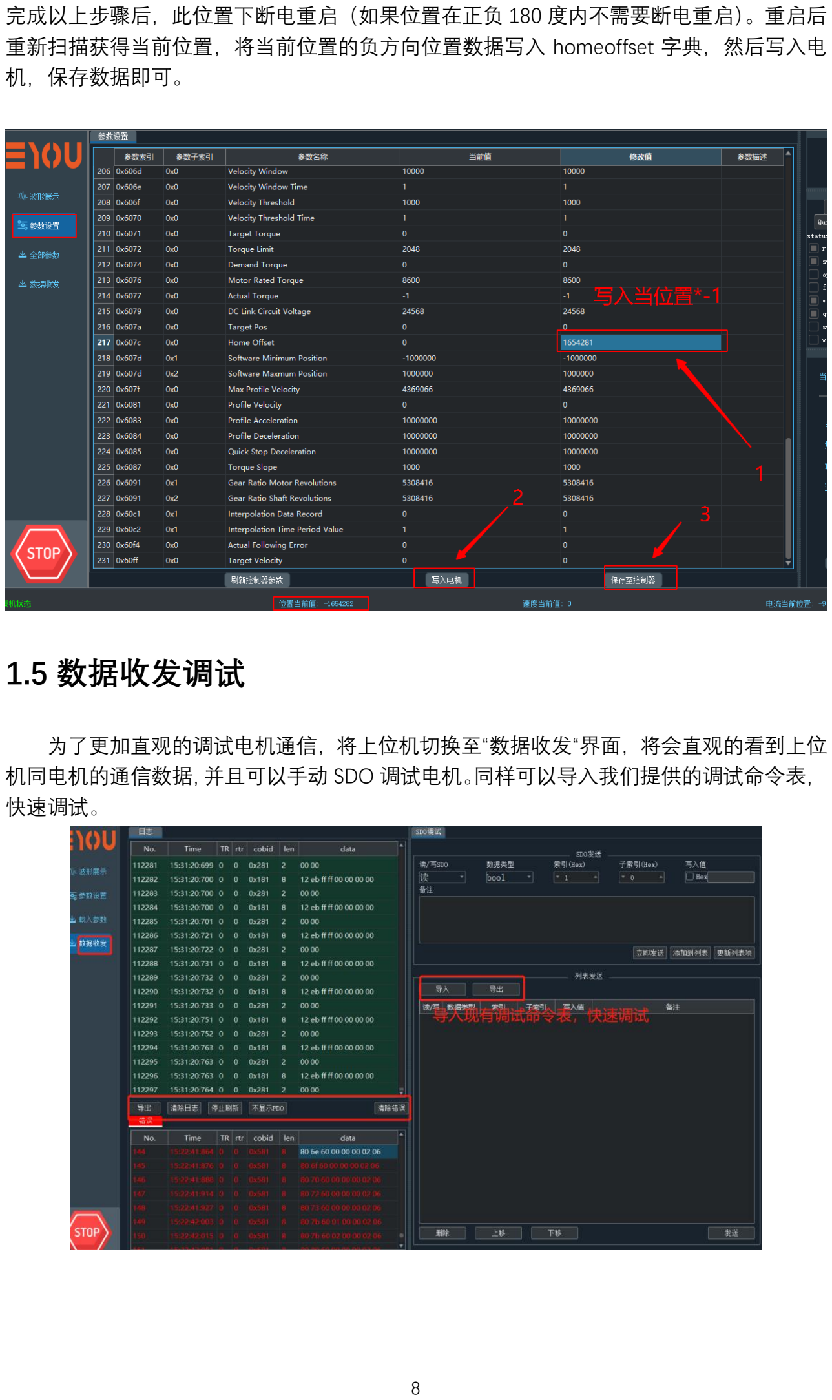
[picture p66: page 8]

完成以上步骤后，此位置下断电重启（如果位置在正负 180 度内不需要断电重启）。重启后 重新扫描获得当前位置，将当前位置的负方向位置数据写入 homeoffset 字典，然后写入电 机，保存数据即可。

## 1.5 数据收发调试

为了更加直观的调试电机通信，将上位机切换至“数据收发“界面，将会直观的看到上位 机同电机的通信数据，并且可以手动 SDO 调试电机。同样可以导入我们提供的调试命令表， 快速调试。

## 2，EyouCanableTool 调试使用

EyouCanTool 是我司开发的配套硬件 canable 的 can 调试上位机，客户也可以使用其他 can 工具和上位机进行调试。EyouCanTool 打开后截图如下：

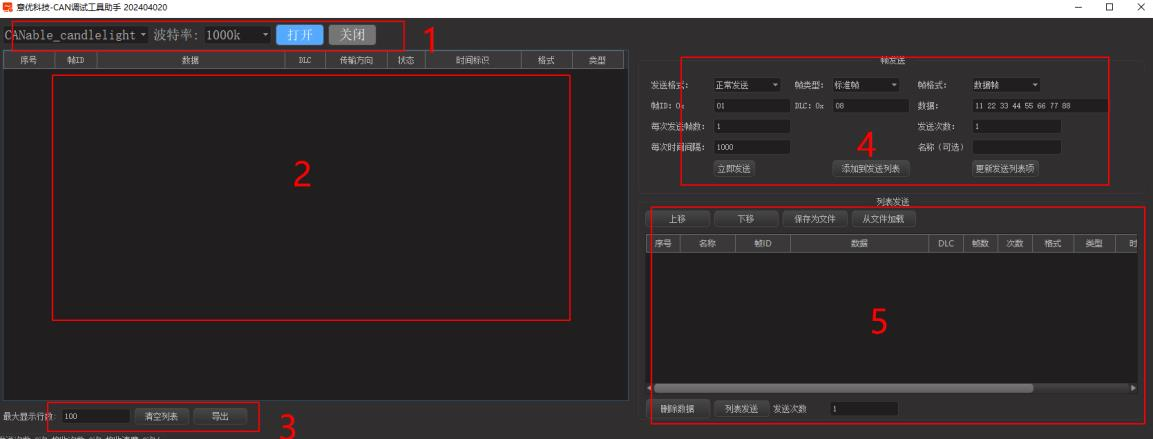
[picture p67: figure]

功能区 1：选择电机对应波特率打开即可，如果打开失败检查 usbcan 是否插入或被占用。 功能区 2：通信数据显示区域。
功能区 3：显示数据行数显示，如果需要记录更多数据加大此参数。同事支持数据导出功能。 功能区 4：can 数据发送。
功能区 5：列表命令发送区域，通过<文件加载>按钮添加集成好的命令表.ini，可以快速调 试调试。也可以把调试的好指令表导出保存。

## 3，应用开发

## 3.1 PDO 配置及映射

Canopen 应用中，Rpdo 和 Tpdo 都是以 canopen 从机的角度定义的，rpdo 就是主机发数据 到从机，无需像 sdo 通信返回数据，tpdo 是从机向主机上传数据，也无需主机返回。主从 机怎么识别通信的数据需要根据 pdo 的配置和映射，举例如下：

## 3.1.1TPDO 配置

举例 1，配置 id=1 电机，周期=1000ms 上传当前速度、当前位置、状态字、故障码，配置 命令表如下：

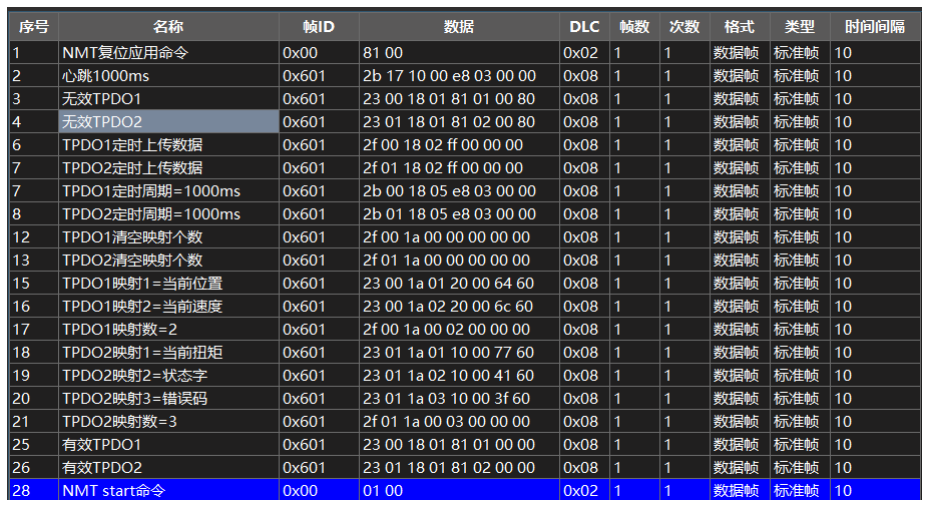
[picture p68: figure]

EYouCanableTool 通信配置截图如下：

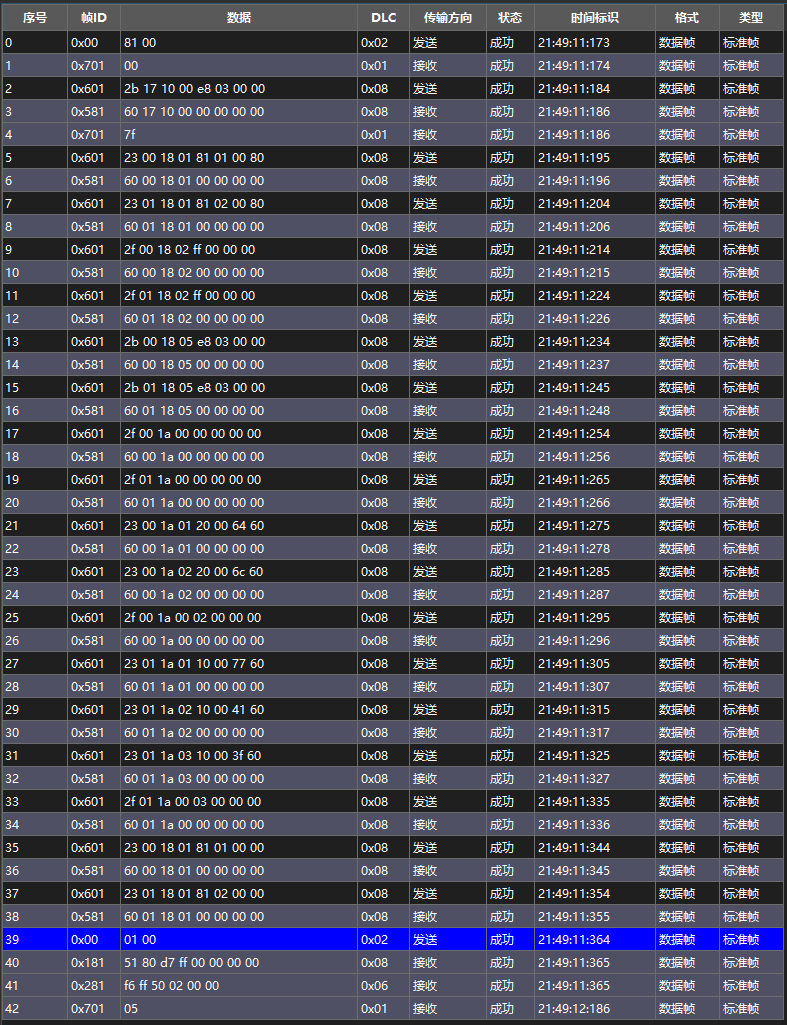
[picture p69: figure]

Can 数据分析：
方向 | id（hex） | Can data(hex) | 说明
发送 | 00 | 81 00 | Nmt 复位应用，配置 pdo 开始需要此指令
返回 | 无 | 无
发送 | 601 | 2b 17 10 00 e8 03 00 00 | 配置电机发出心跳报文，周期=1000ms
返回 | 581 | 60 17 10 00 00 00 00 00
发送 | 601 | 23 00 18 01 81 01 00 80 | 无效 TPDO1
返回 | 581 | 60 00 18 01 00 00 00 00
发送 | 601 | 23 01 18 01 81 02 00 80 | 无效 TPDO2
返回 | 581 | 60 01 18 01 00 00 00 00
发送 | 601 | 2f 00 18 02 ff 00 00 00 | TPDO1 异步模式，定时上传
返回 | 581 | 60 00 18 02 00 00 00 00
发送 | 601 | 2f 01 18 02 ff 00 00 00 | TPDO2 异步模式，定时上传
返回 | 581 | 60 01 18 02 00 00 00 00
发送 | 601 | 2b 00 18 05 e8 03 00 00 | TPDO1 上传周期=1000ms
返回 | 581 | 60 00 18 05 00 00 00 00

发送 | 601 | 2b 01 18 05 e8 03 00 00 | TPDO2 上传周期=1000ms
返回 | 581 | 60 01 18 05 00 00 00 00
发送 | 601 | 2f 00 1a 00 00 00 00 00 | TPDO1 清空映射个数
返回 | 581 | 60 00 1a 00 00 00 00 00
发送 | 601 | 2f 01 1a 00 00 00 00 00 | TPDO2 清空映射个数
返回 | 581 | 60 01 1a 00 00 00 00 00
发送 | 601 | 23 00 1a 01 20 00 64 60 | TPDO1 映射 1=当前位置
返回 | 581 | 60 00 1a 01 00 00 00 00
发送 | 601 | 23 00 1a 02 20 00 6c 60 | TPDO1 映射 2=当前速度
返回 | 581 | 60 00 1a 02 00 00 00 00
发送 | 601 | 2f 00 1a 00 02 00 00 00 | TPDO1 映射数=2
返回 | 581 | 60 00 1a 00 00 00 00 00
发送 | 601 | 23 01 1a 01 10 00 77 60 | TPDO2 映射 1=当前扭矩
返回 | 581 | 60 01 1a 01 00 00 00 00
发送 | 601 | 23 01 1a 02 10 00 41 60 | TPDO2 映射 2=状态字
返回 | 581 | 60 01 1a 02 00 00 00 00
发送 | 601 | 23 01 1a 03 10 00 3f 60 | TPDO2 映射 3=错误码
返回 | 581 | 60 01 1a 03 00 00 00 00
发送 | 601 | 2f 01 1a 00 03 00 00 00 | TPDO2 映射数=3
返回 | 581 | 60 01 1a 00 00 00 00 00
发送 | 601 | 23 00 18 01 81 01 00 00 | 有效 TPDO1
返回 | 581 | 60 00 18 01 00 00 00 00
发送 | 601 | 23 01 18 01 81 02 00 00 | 有效 TPDO2
返回 | 581 | 60 01 18 01 00 00 00 00
发送 | 00 | 01 00 | NMT start 所有从机命令
以上完成 tpdo 配置，nmt start 指令后，tpdo 开始按照 1000ms 周期上传，下面是收到 tpdo 数据及心跳数据
返回 | 181 | 51 80 d7 ff 00 00 00 00 | 181 为 id=1 电机 tpdo1 的 canid 51 80 d7 ff -> 当 前 位 置 ,int32 类 型 ， 0xffd78051 对应十进制-2654217 00 00 00 00 ->当前速度,int32 类型
返回 | 281 | f6 ff 50 02 00 00 | 281 为 id=1 电机的 tpdo2 的 canid f6 ff ->当前扭矩值，int16 50 02 ->状态字，uint16 00 00 ->错误码，uint16，0 代表无错误
返回 | 701 | 05 | canId=700+id，心跳 id，05 为操作状态 0x04：停止状态 0x7f：预操作状态

举例 2，配置 id=11(0x0b)电机，周期=1000ms 上传当前速度、当前位置、状态字、故障码， 配置命令表如下：

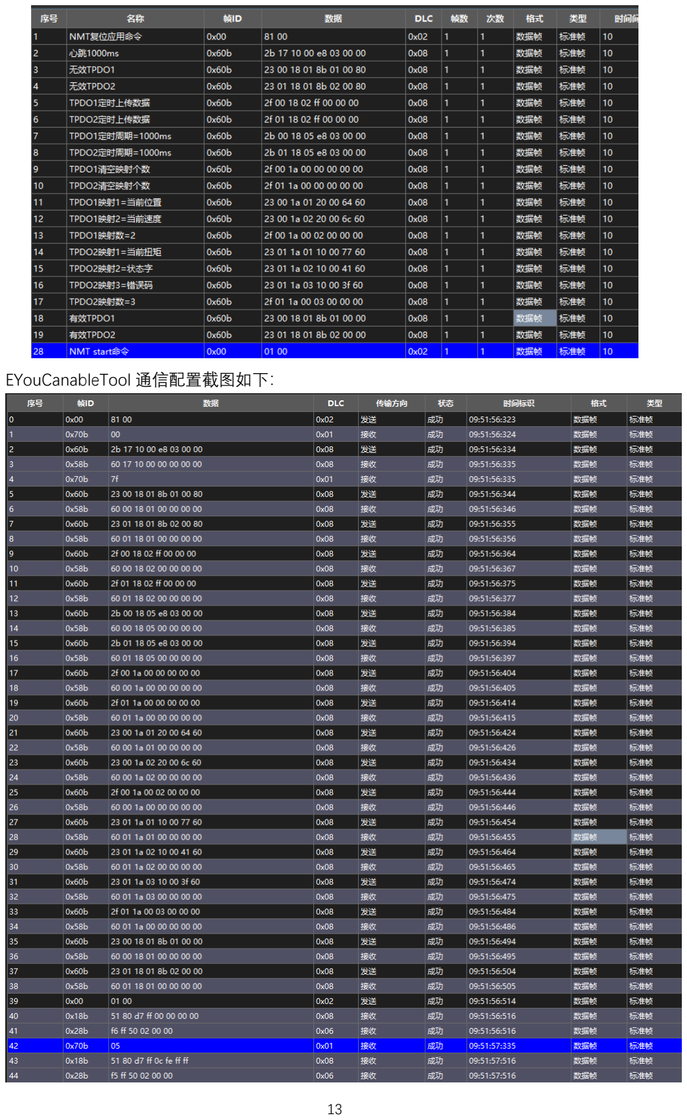
[picture p70: page 13]

EYouCanableTool 通信配置截图如下：

Can 数据分析：
方向 | id（hex） | Can data(hex) | 说明
发送 | 00 | 81 00 | Nmt 复位应用，配置 pdo 开始需要此指令
返回 | 无 | 无
发送 | 60b | 2b 17 10 00 e8 03 00 00 | 配置电机发出心跳报文，周期=1000ms
返回 | 58b | 60 17 10 00 00 00 00 00
发送 | 60b | 23 00 18 01 8b 01 00 80 | 无效 TPDO1
返回 | 58b | 60 00 18 01 00 00 00 00
发送 | 60b | 23 01 18 01 8b 02 00 80 | 无效 TPDO2
返回 | 58b | 60 01 18 01 00 00 00 00
发送 | 60b | 2f 00 18 02 ff 00 00 00 | TPDO1 异步模式，定时上传
返回 | 58b | 60 00 18 02 00 00 00 00
发送 | 60b | 2f 01 18 02 ff 00 00 00 | TPDO2 异步模式，定时上传
返回 | 58b | 60 01 18 02 00 00 00 00
发送 | 60b | 2b 00 18 05 e8 03 00 00 | TPDO1 上传周期=1000ms
返回 | 58b | 60 00 18 05 00 00 00 00
发送 | 60b | 2b 01 18 05 e8 03 00 00 | TPDO2 上传周期=1000ms
返回 | 58b | 60 01 18 05 00 00 00 00
发送 | 60b | 2f 00 1a 00 00 00 00 00 | TPDO1 清空映射个数
返回 | 58b | 60 00 1a 00 00 00 00 00
发送 | 60b | 2f 01 1a 00 00 00 00 00 | TPDO2 清空映射个数
返回 | 58b | 60 01 1a 00 00 00 00 00
发送 | 60b | 23 00 1a 01 20 00 64 60 | TPDO1 映射 1=当前位置
返回 | 58b | 60 00 1a 01 00 00 00 00
发送 | 60b | 23 00 1a 02 20 00 6c 60 | TPDO1 映射 2=当前速度
返回 | 58b | 60 00 1a 02 00 00 00 00
发送 | 60b | 2f 00 1a 00 02 00 00 00 | TPDO1 映射数=2
返回 | 58b | 60 00 1a 00 00 00 00 00
发送 | 60b | 23 01 1a 01 10 00 77 60 | TPDO2 映射 1=当前扭矩
返回 | 58b | 60 01 1a 01 00 00 00 00
发送 | 60b | 23 01 1a 02 10 00 41 60 | TPDO2 映射 2=状态字
返回 | 58b | 60 01 1a 02 00 00 00 00
发送 | 60b | 23 01 1a 03 10 00 3f 60 | TPDO2 映射 3=错误码
返回 | 58b | 60 01 1a 03 00 00 00 00
发送 | 60b | 2f 01 1a 00 03 00 00 00 | TPDO2 映射数=3
返回 | 58b | 60 01 1a 00 00 00 00 00
发送 | 60b | 23 00 18 01 8b 01 00 00 | 有效 TPDO1
返回 | 58b | 60 00 18 01 00 00 00 00
发送 | 60b | 23 01 18 01 8b 02 00 00 | 有效 TPDO2
返回 | 58b | 60 01 18 01 00 00 00 00
发送 | 00 | 01 00 | NMT start 所有从机命令
以上完成 tpdo 配置，nmt start 指令后，tpdo 开始按照 1000ms 周期上传，下面是收到 tpdo 数据及心跳数据

返回 | 18b | 51 80 d7 ff 00 00 00 00 | 18b 为 id=0x0b(11)电机 tpdo1 的 canid 51 80 d7 ff -> 当 前 位 置 ,int32 类 型 ， 0xffd78051 对应十进制-2654217 00 00 00 00 ->当前速度,int32 类型
返回 | 28b | f6 ff 50 02 00 00 | 28b 为 id=0x0b(11)电机的 tpdo2 的 canid f6 ff ->当前扭矩值，int16 50 02 ->状态字，uint16 00 00 ->错误码，uint16，0 代表无错误
返回 | 70b | 05 | canId=700+id，心跳 id，05 为操作状态 其他 nmt 状态如下： 0x04：停止状态 0x7f：预操作状态

## 3.2 轨迹位置模式应用

轨迹位置模式下，电机根据设置的加减速速度、匀速速度、目标位置规划运行轨迹。 举例 1，如 id=1，101 减速比（输出分辨率=6619136）的电机，sdo 方式控制指令如下： EYouCanableTool 指令表截图如下:

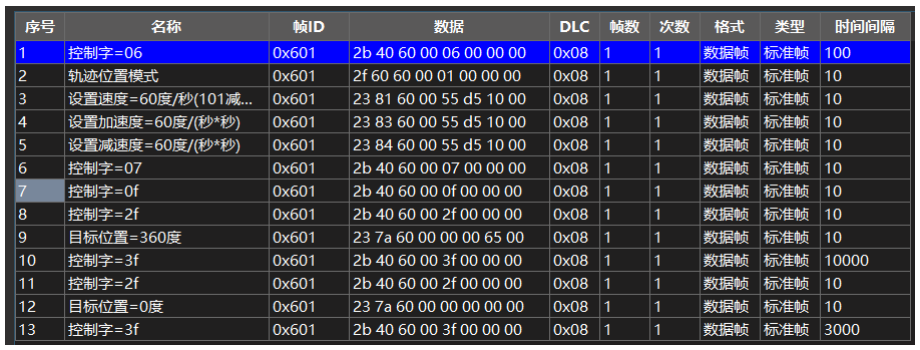
[picture p71: figure]

EYouCanableTool 实际通信截图：

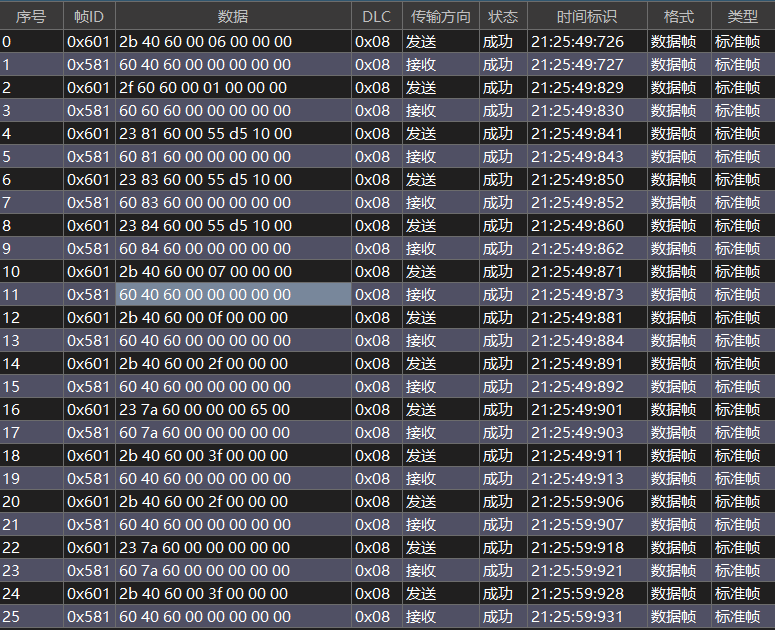
[picture p72: figure]

Can 数据分析：
方向 | id（hex） | Can data(hex) | 说明
发送 | 601 | 2b 40 60 00 06 00 00 00 | 控制字=06，shutdown 指令
返回 | 581 | 60 40 60 00 00 00 00 00
发送 | 601 | 2f 60 60 00 01 00 00 00 | 模式=01，轨迹位置模式
返回 | 581 | 60 60 60 00 00 00 00 00
发送 | 601 | 23 81 60 00 55 d5 10 00 | 设置匀速速度=60 度/秒（101 减速比，速度 1103189/6619136*360 度=60 度/秒）
返回 | 581 | 60 81 60 00 00 00 00 00
发送 | 601 | 23 83 60 00 55 d5 10 00 | 设置加速度=60 度/(秒*秒)
返回 | 581 | 60 83 60 00 00 00 00 00
发送 | 601 | 23 84 60 00 55 d5 10 00 | 设置减速度=60 度/(秒*秒)
返回 | 581 | 60 84 60 00 00 00 00 00
发送 | 601 | 2b 40 60 00 07 00 00 00 | 控制字=0x07，switch on 指令
返回 | 581 | 60 40 60 00 00 00 00 00
发送 | 601 | 2b 40 60 00 0f 00 00 00 | 控制字=0x0f，operation enable 指令
返回 | 581 | 60 40 60 00 00 00 00 00
以上流程指令为上电使能及运动参数配置，到此处电机应处于使能状态，可以通过查询 状态字反馈确认状态迁移是否正常
发送 | 601 | 2b 40 60 00 2f 00 00 00 | 控制字=0x2f，绝对位置立即更新重置标志
返回 | 581 | 60 40 60 00 00 00 00 00

发送 | 601 | 23 7a 60 00 00 00 65 00 | 目标位置=360 度位置(绝对位置)
返回 | 581 | 60 7a 60 00 00 00 00 00
发送 | 601 | 2b 40 60 00 3f 00 00 00 | 控制字=0x3f，绝对位置立即更新置位标志
返回 | 581 | 60 40 60 00 00 00 00 00
以上三条指令为绝对位置更新指令，后续使能状态下，只需要更新这三条指令即可设置 新目标位置。
根据状态字 bit10 是否=1 或判断实际位置和目标位置差值来判断之前目标位置是否已经 完成，然后根据需要更新后续新位置。
当然也可以根据实际需要直接更新目标位置，如果是在运行中，电机会打断之前的轨迹 重新规划新的运行轨迹。
发送 | 601 | 2b 40 60 00 2f 00 00 00 | 控制字=0x2f，绝对位置立即更新重置标志
返回 | 581 | 60 40 60 00 00 00 00 00
发送 | 601 | 23 7a 60 00 00 00 00 00 | 目标位置=0 度位置(绝对位置)
返回 | 581 | 60 7a 60 00 00 00 00 00
发送 | 601 | 2b 40 60 00 3f 00 00 00 | 控制字=0x3f，绝对位置立即更新置位标志
返回 | 581 | 60 40 60 00 00 00 00 00
以上三条指令为绝对位置更新指令，后续使能状态下， 如果一直保持输出运行，循环发 送这三条指令即可。
运行过程中根据需要可以按照不同方式选择停止模式，此处选择 shutdown 停机方式和 halt 暂停停机两种方式举例，根据需要选其中一个即可。
发送 | 601 | 2b 40 60 00 06 00 00 00 | 控制字=0x06，shutdown 指令停机，按照减 速度斜坡停机，停止后下使能停止输出，抱 闸抱死。需要再次走上使能指令流程才能继 续控制输出。
返回 | 581 | 60 40 60 00 00 00 00 00
发送 | 601 | 2b 40 60 00 0f 01 00 00 | 控制字=0x10f，halt 指令停机，按照减速度 斜坡停机，停止后不下使能，保持输出，后 续控制可以继续按照上面 2f-新位置-3f 指 令顺序继续更新位置
返回 | 581 | 60 40 60 00 00 00 00 00

举例 2：如 id=11（0x0b），121 减速比（输出分辨率=7929856）的电机，sdo 方式控制指令 如下：
EYouCanableTool 指令表截图如下:

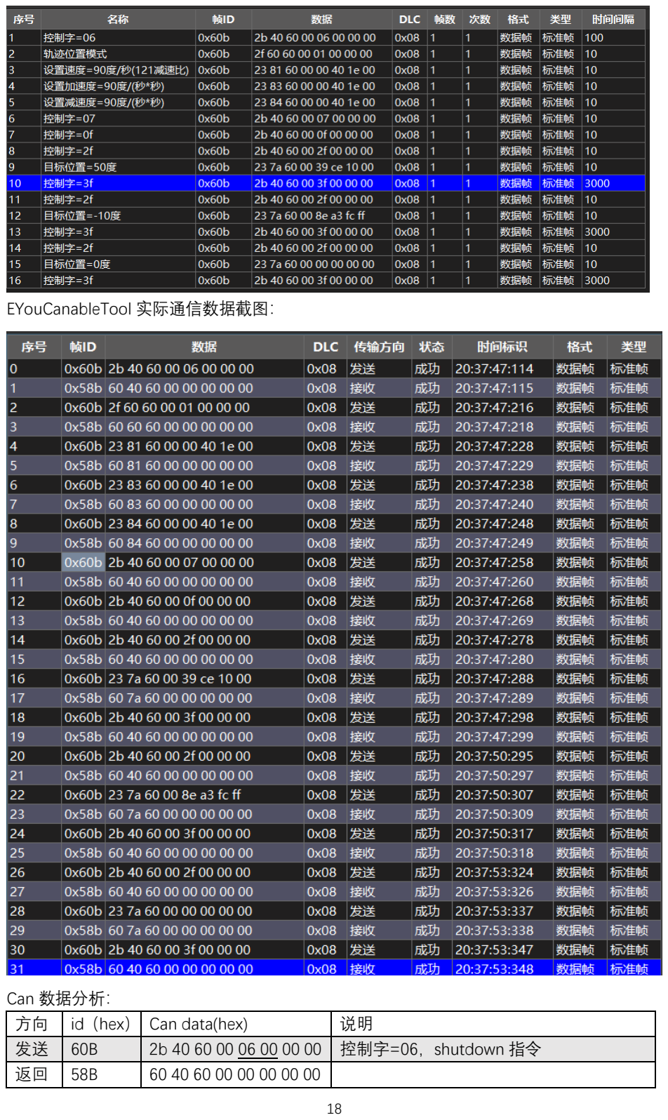
[picture p73: page 18]

EYouCanableTool 实际通信数据截图：

Can 数据分析：
方向 | id（hex） | Can data(hex) | 说明
发送 | 60B | 2b 40 60 00 06 00 00 00 | 控制字=06，shutdown 指令
返回 | 58B | 60 40 60 00 00 00 00 00

发送 | 60B | 2f 60 60 00 01 00 00 00 | 模式=01，轨迹位置模式
返回 | 58B | 60 60 60 00 00 00 00 00
发送 | 60B | 23 81 60 00 00 40 1e 00 | 设置匀速速度=90 度/秒（121 减速比，速度 1982464/7929856*360 度=90 度/秒）
返回 | 58B | 60 81 60 00 00 00 00 00
发送 | 60B | 23 83 60 00 00 40 1e 00 | 设置加速度=60 度/(秒*秒)
返回 | 58B | 60 83 60 00 00 00 00 00
发送 | 60B | 23 84 60 00 00 40 1e 00 | 设置减速度=60 度/(秒*秒)
返回 | 58B | 60 84 60 00 00 00 00 00
发送 | 60B | 2b 40 60 00 07 00 00 00 | 控制字=0x07，switch on 指令
返回 | 58B | 60 40 60 00 00 00 00 00
发送 | 60B | 2b 40 60 00 0f 00 00 00 | 控制字=0x0f，operation enable 指令
返回 | 58B | 60 40 60 00 00 00 00 00
以上流程指令为上电使能及运动参数配置，到此处电机应处于使能状态，可以通过查询 状态字反馈确认状态迁移是否正常
发送 | 60B | 2b 40 60 00 2f 00 00 00 | 控制字=0x2f，绝对位置立即更新重置标志
返回 | 58B | 60 40 60 00 00 00 00 00
发送 | 60B | 23 7a 60 00 39 ce 10 00 | 目标位置=50 度位置(绝对位置)
返回 | 58B | 60 7a 60 00 00 00 00 00
发送 | 60B | 2b 40 60 00 3f 00 00 00 | 控制字=0x3f，绝对位置立即更新置位标志
返回 | 58B | 60 40 60 00 00 00 00 00
以上三条指令为绝对位置更新指令，后续使能状态下，只需要更新这三条指令即可设置 新目标位置。
根据状态字 bit10 是否=1 或判断实际位置和目标位置差值来判断之前目标位置是否已经 完成，然后根据需要更新后续新位置。
当然也可以根据实际需要直接更新目标位置，如果是在运行中，电机会打断之前的轨迹 重新规划新的运行轨迹。
发送 | 60B | 2b 40 60 00 2f 00 00 00 | 控制字=0x2f，绝对位置立即更新重置标志
返回 | 58B | 60 40 60 00 00 00 00 00
发送 | 60B | 23 7a 60 00 8e a3 fc ff | 目标位置=-10 度位置(绝对位置)
返回 | 58B | 60 7a 60 00 00 00 00 00
发送 | 60B | 2b 40 60 00 3f 00 00 00 | 控制字=0x3f，绝对位置立即更新置位标志
返回 | 58B | 60 40 60 00 00 00 00 00
判断位置到达后，继续更新下面的新位置指令
发送 | 60B | 2b 40 60 00 2f 00 00 00 | 控制字=0x2f，绝对位置立即更新重置标志
返回 | 58B | 60 40 60 00 00 00 00 00
发送 | 60B | 23 7a 60 00 00 00 00 00 | 目标位置=0 度位置(绝对位置)
返回 | 58B | 60 7a 60 00 00 00 00 00
发送 | 60B | 2b 40 60 00 3f 00 00 00 | 控制字=0x3f，绝对位置立即更新置位标志
返回 | 58B | 60 40 60 00 00 00 00 00
以上三条指令为绝对位置更新指令，后续使能状态下， 如果一直保持输出运行，循环发 送这三条指令即可。
运行过程中根据需要可以按照不同方式选择停止模式，此处选择 shutdown 停机方式和 halt 暂停停机两种方式举例，根据需要选其中一个即可。
发送 | 60B | 2b 40 60 00 06 00 00 00 | 控制字=0x06，shutdown 指令停机，按照减 速度斜坡停机，停止后下使能停止输出，抱 闸抱死。需要再次走上使能指令流程才能继 续控制输出。
返回 | 58B | 60 40 60 00 00 00 00 00
发送 | 60B | 2b 40 60 00 0f 01 00 00 | 控制字=0x10f，halt 指令停机，按照减速度 斜坡停机，停止后不下使能，保持输出，后 续控制可以继续按照上面 2f-新位置-3f 指 令顺序继续更新位置
返回 | 58B | 60 40 60 00 00 00 00 00
