rocketman123456/eyou_motor/model/谐波关节模型图2.0-241224/PH25-2.0.pdf

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

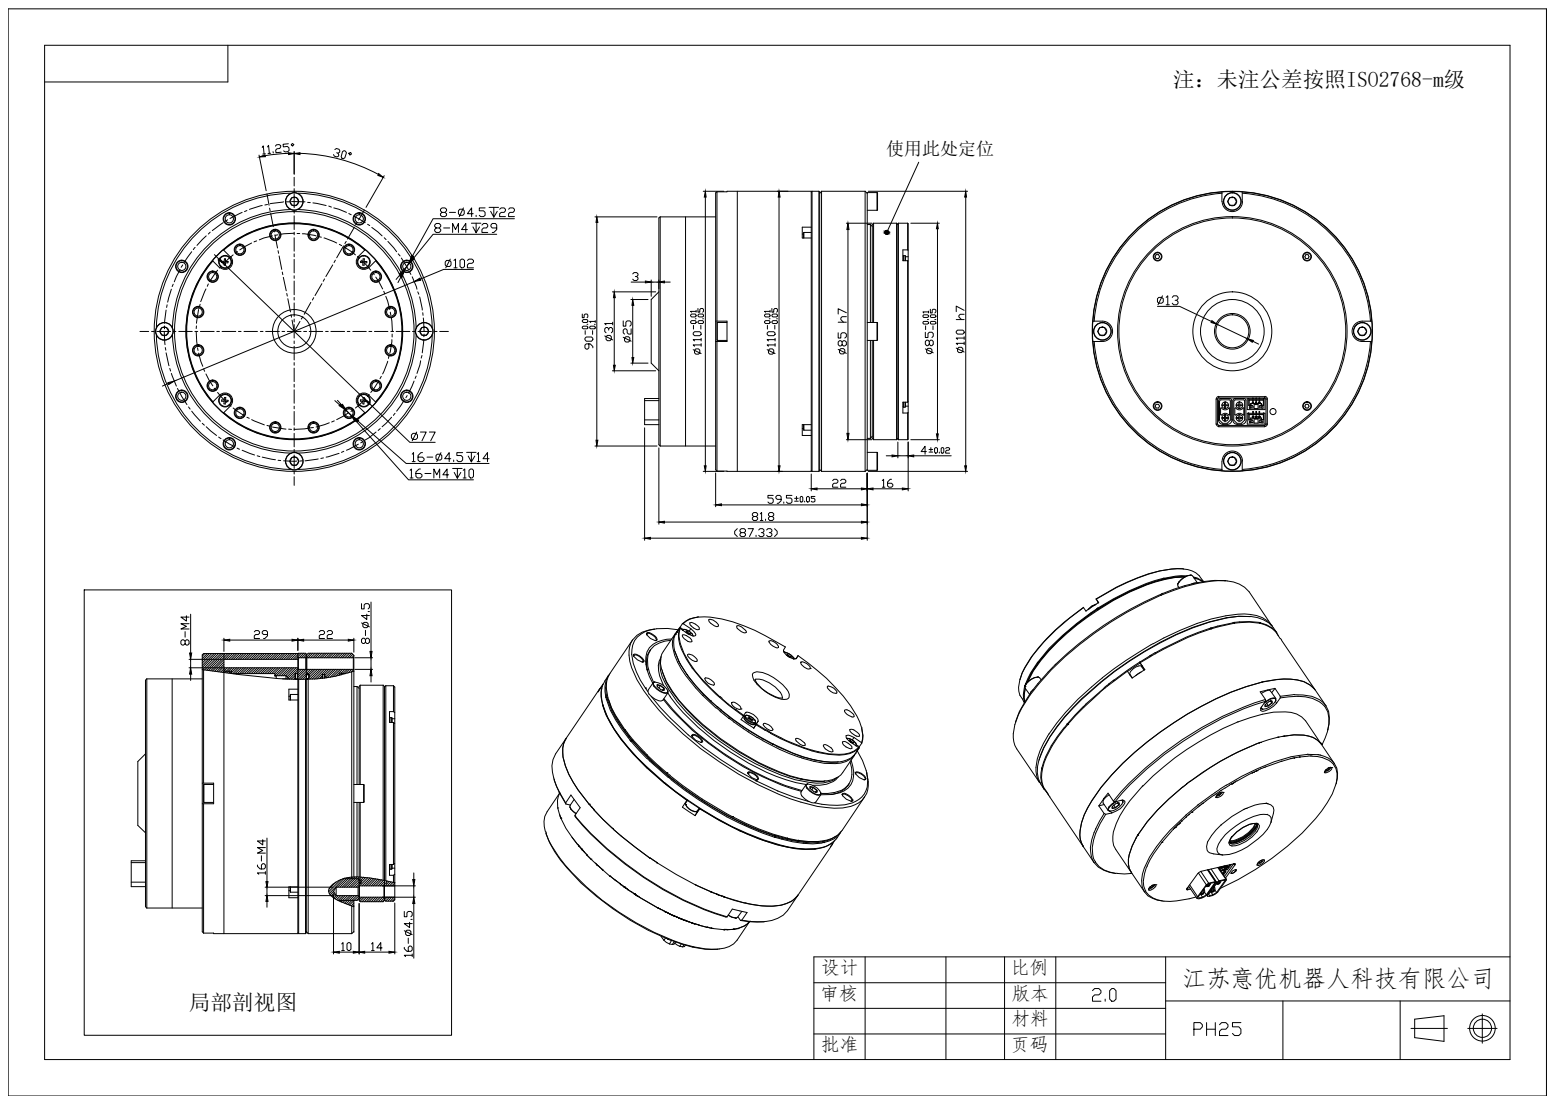
[picture p79: page 1]
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
