rocketman123456/eyou_motor/(commit log)

2025-03-02 [UPDATE] update some doc and model
    [PH08-2.0.stp, PH08-2.1.stp, PH11-2.0.stp, PH11-2.1.stp]
2025-03-03 [ADD] add plant motor data
